CaptainBertie/D-Sentry/Mechanical/Gcode/README.md

# Gcode

Sliced for a Prusa MK3S: PETG, 0.6 mm nozzle, 0.35 mm layers unless noted; the pan pinion in
nylon.

- **`final/`**: the turret's parts: `Base`, `Foot`, `Frame`, `Gears`, `LeftLid`, `LeftMount`,
  `RightMount`, `RLid+BC`, `Shooter`, `ShooterBase`, `ShooterPinion`, `TiltGear`, `TiltPinion`,
  `CFPinion`, `LCD+NEMA`, `Rack`.
- **`testing/`**: fit and calibration prints (bearing, bolt, nut, pin, magnet, switch and
  mount-width tests), an early frame, and five earlier racks.

Measured results: `../fitment.md`.
