CaptainBertie/D-Sentry/Mechanical/fitment.md

# Fitment

Measured from the fit-test prints in `Gcode/testing/`.

## Fastener holes

The same sizes work for vertical and horizontal holes.

| Fastener | Clearance | Self-tap | Counterbore |
|---|---|---|---|
| M2 | 2.7 mm | 2.3 mm | 3.9 mm |
| M3 | 3.6 mm | 3.1 mm | 6.2 mm |
| M4 | 4.5 mm | 4.1 mm | 8.1 mm |

Where each size goes:

- **M4**: frame (self-tap, clearance, push-in nut), left and right mounts (clearance, push-in
  nut), left and right lids, bottom panel and base (clearance).
- **M3**: frame and left mount (self-tap).
- **M2**: frame (self-tap).
- **M5**: shooter (clearance).

## Other fits

| Fit | Value | Notes |
|---|---|---|
| 608 bearing | 22.3 mm OD, 7.1 mm ID | Nominal is 22 × 7 mm. |
| BB cartridge | −0.3 mm, bottom removed, 0.6 mm stickout | |
| Foot well | 21 mm | |
| Window | 3.175 mm wide | Laser-cut acrylic. |
| LCD pocket | −0.1 mm | Press fit. |
| NEMA D-shaft bore | 5.20 mm Ø, 4.7 mm across the flat | |
