CaptainBertie/D-Sentry/Software/firmware-architecture.html

D-SENTRY · FIRMWARE ARCHITECTURE

# How the turret decides, and what it's wired to

Two diagrams built from docs/architecture.md and firmware-ra4m1/dsentry/src/App.cpp: first, every path a button press can take to reach the RA4M1's motors and servo — and which one wins when more than one is live. Second, the exact order App::loop() runs, forever, and the state machine its one decision-maker steps through.

control data — commands the turret acts on telemetry / status — reported back mechanical / sensor wiring bench override — always wins

## 01 System block diagram

The Xbox pad reaches the RA4M1 brain by one of three paths, never more than one at a time. A valid packet over the USB bench cable always beats the radio, and switching which path is active counts as a link loss — the turret stops and comes back disarmed.

Dashed arrows at top: the pad pairs with exactly one side, chosen by the A1 mode toggle. The USB path (thick, from the Mac) is the bench override — it wins over either radio path whenever a valid packet has arrived in the last LINK_TIMEOUT_MS, and swapping which source is live is itself treated as a link loss.

## 02 Firmware flowchart

dsentry.ino is two lines: app.begin() once, then app.loop() forever. Both run in a fixed order the modules depend on — this is that order, from App.cpp.

Nothing in loop() blocks except SERVO ADJUST's save (about 50 ms, only in DISARMED with nothing moving) — that's the one documented exception to the no-delay() rule.

What TurretState.update() moves through, from docs/architecture.md §6. Solid arrows are the normal path; dashed arrows are the fault branch, which can cut in from calibrating, disarmed or armed.

Source: docs/architecture.md · firmware-ra4m1/dsentry/src/App.cpp · firmware-ra4m1/dsentry/src/TurretState.h — d-sentry branch, as of 2026-11-03.
