CaptainBertie/D-Sentry/Software/architecture-diagram.png

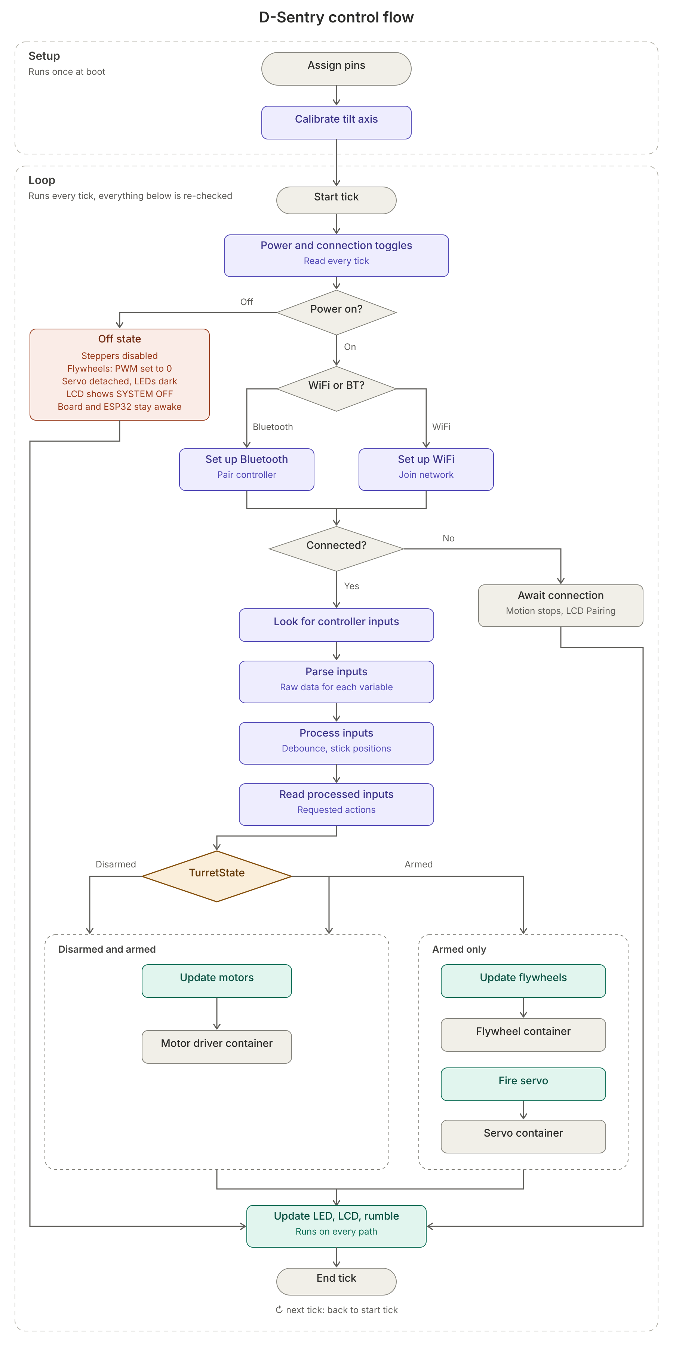
Software/architecture-diagram.png
