CaptainBertie/D-Sentry/Mechanical/CAD/vendor-parts/battery-6s-5200mah/Battery Screenshot.png

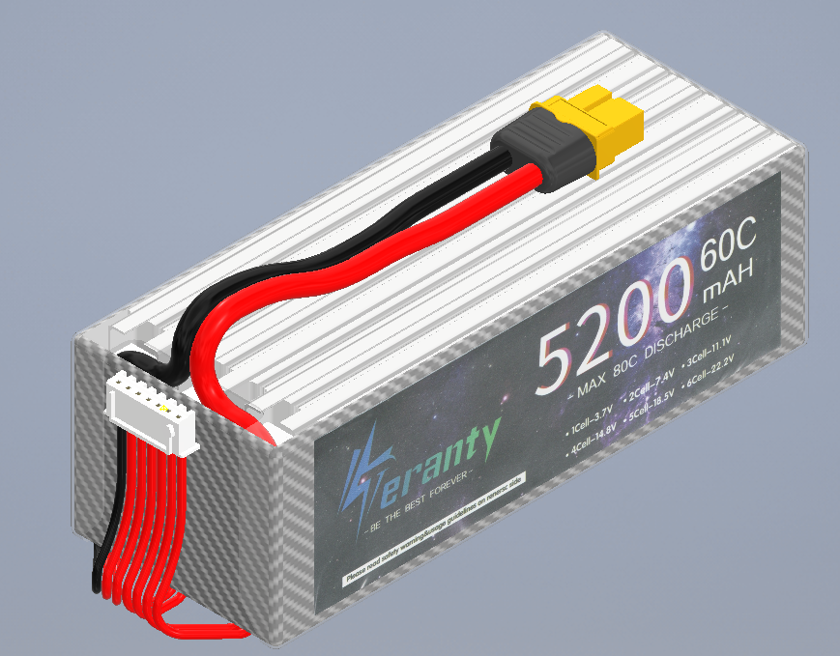
Mechanical/CAD/vendor-parts/battery-6s-5200mah/Battery Screenshot.png
