CaptainBertie/D-Sentry/Mechanical/CAD/vendor-parts/battery-6s-5200mah/Label - Front.jpg

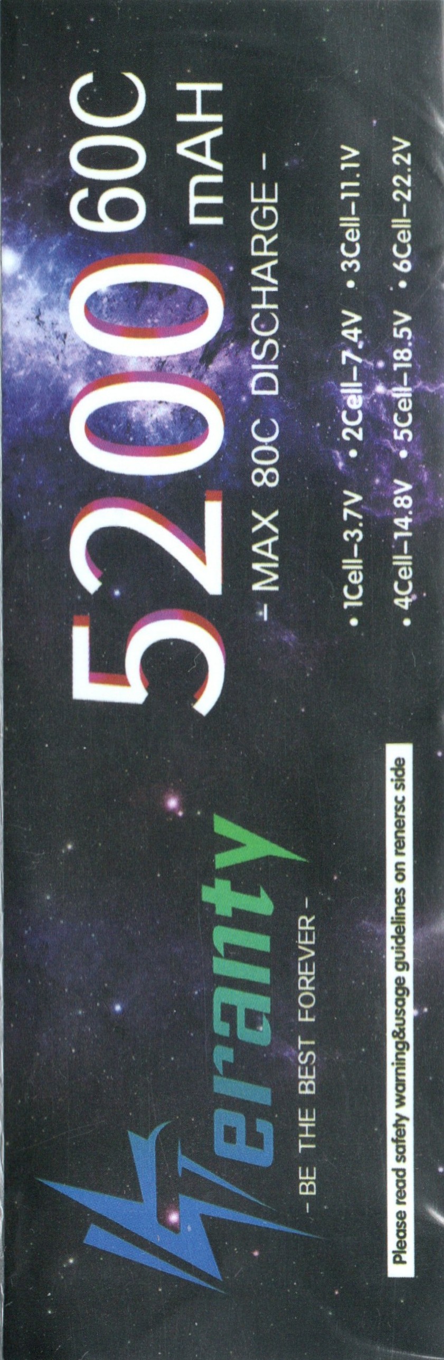
Mechanical/CAD/vendor-parts/battery-6s-5200mah/Label - Front.jpg
