CaptainBertie/D-Sentry/Mechanical/CAD/vendor-parts/cnc-shield-v3/Arduino_CNC_Assembly.STEP

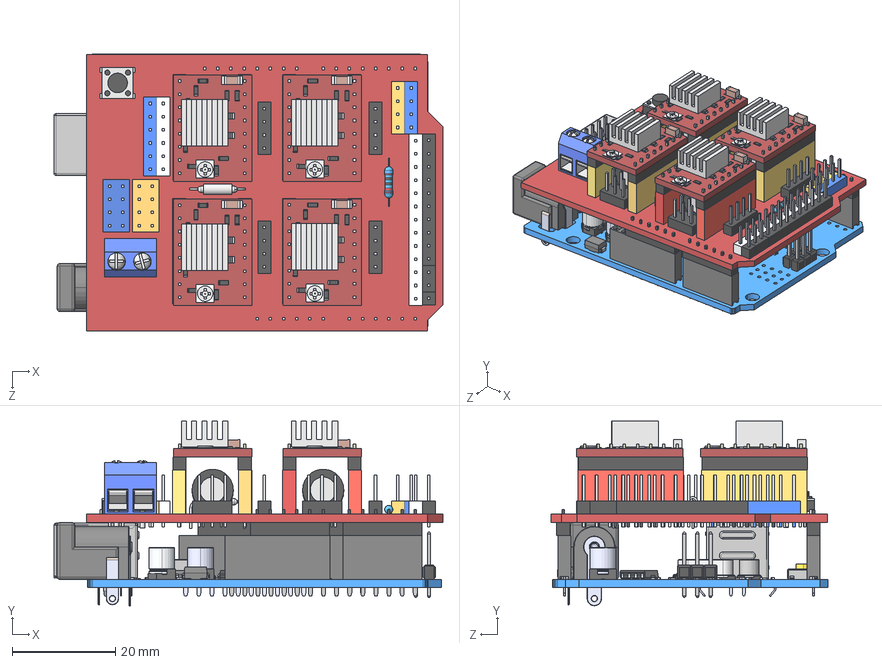
[picture p7: CAD file, 2026-11-13]
Mechanical/CAD/vendor-parts/cnc-shield-v3/Arduino_CNC_Assembly.STEP
75.3 x 35.7 x 53.6 mm
PCB.stp
USB-B.stp
DC_Jack.stp
Header female 8.stp
Header female 10.stp
Header female 8 (2).stp
Header female 6.stp
Header male 2.stp
Header male 2 (2).stp
Header male 2 (3).stp
Atmega328p-AU.stp
Diode.stp
LM358.stp
16MHZ Crystal.stp
16MHZ Crystal (2).stp
0603 Package.stp
0603 Package (2).stp
0603 Package (3).stp
0603 Package (4).stp
0603 Package (5).stp
0603 Package (6).stp
0603 Package (7).stp
0603 Package (8).stp
R1.stp
0603 Package (24).stp
0603 Package (23).stp
0603 Package (22).stp
0603 Package (21).stp
0603 Package (20).stp
0603 Package (19).stp
0603 Package (18).stp
0603 Package (17).stp
0603 Package (16).stp
0603 Package (15).stp
0603 Package (14).stp
0603 Package (13).stp
0603 Package (12).stp
0603 Package (11).stp
0603 Package (10).stp
0603 Package (9).stp
CH340G.stp
47uF 27v cap.stp
47uF 27v cap (2).stp
LM1117.stp
Transistor SOC Package.stp
Transistor SOC Package (2).stp
A sexy yellow button.stp
Arduino_Uno_CNC_Shield_V3
