CaptainBertie/D-Sentry/Mechanical/CAD/vendor-parts/l298n-stepper-driver/ENB Pin.SLDASM

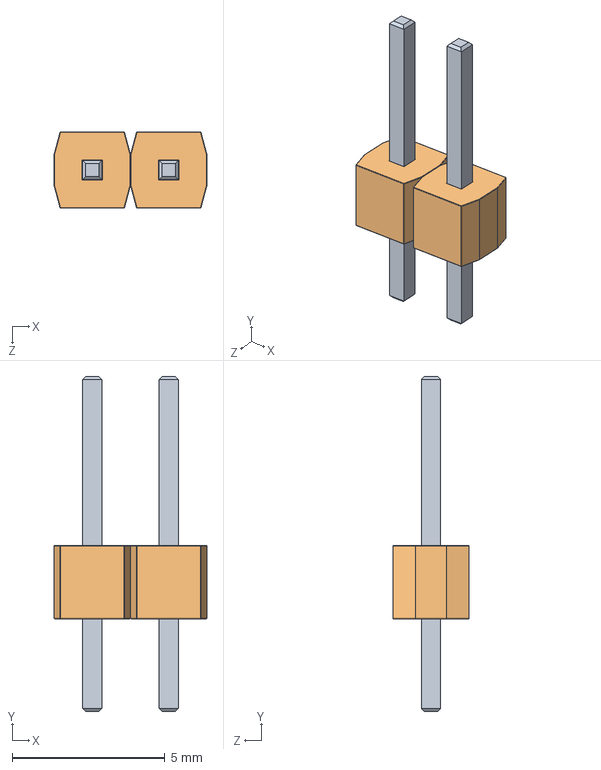
[picture p8: CAD file, 2026-11-13]
Mechanical/CAD/vendor-parts/l298n-stepper-driver/ENB Pin.SLDASM
5.00 x 10.9 x 2.50 mm
Spacer x 2
Male Header Pin x 2
