CaptainBertie/D-Sentry/Mechanical/CAD/vendor-parts/servo-fs90r/Solidworks 2022/Fitec FS90R_Micro Servo.SLDASM

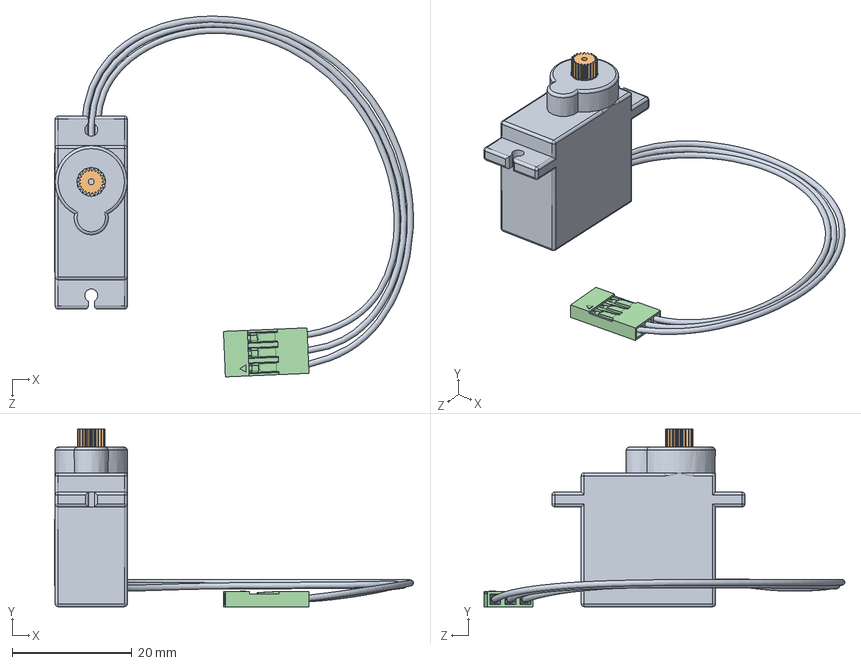
[picture p9: CAD file, 2026-11-13]
Mechanical/CAD/vendor-parts/servo-fs90r/Solidworks 2022/Fitec FS90R_Micro Servo.SLDASM
60.0 x 29.7 x 60.3 mm
FS90R_Housing
spur gear_din_0.2M 21T 21PA 3FW
Label
BLS-3 by Dmitry Levin.step
