CaptainBertie/D-Sentry/Mechanical/CAD/vendor-parts/l298n-stepper-driver/Left Cap.SLDASM

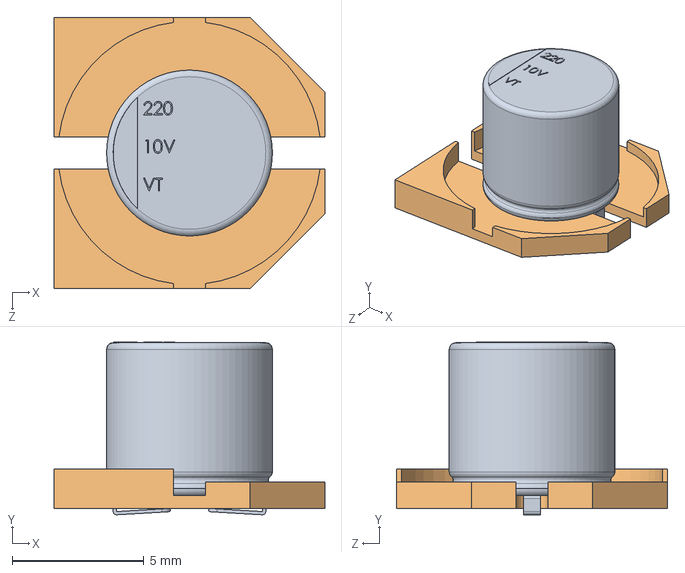
[picture p10: CAD file, 2026-11-13]
Mechanical/CAD/vendor-parts/l298n-stepper-driver/Left Cap.SLDASM
10.3 x 6.56 x 10.3 mm
Plastic Base
Cap Body
