CaptainBertie/D-Sentry/Mechanical/CAD/meshes/ShooterProto.3mf

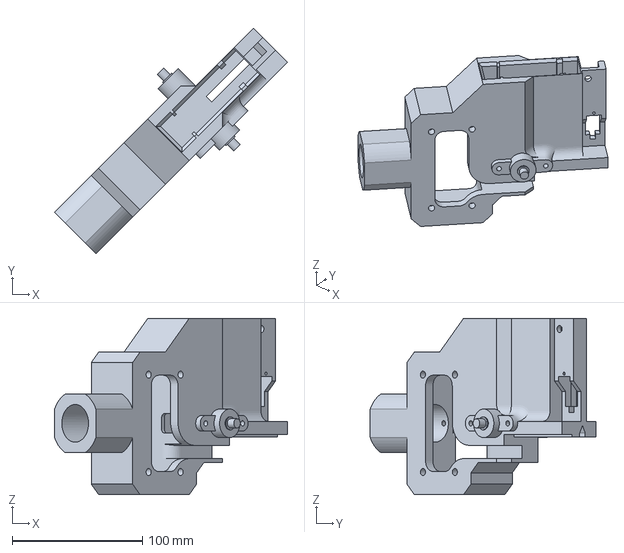
[picture p11: CAD file, 2026-11-13]
Mechanical/CAD/meshes/ShooterProto.3mf
179.1 x 173.4 x 135.5 mm
