CaptainBertie/D-Sentry/Mechanical/CAD/vendor-parts/battery-6s-5200mah/6S  22.2v 5200maH 60C .stp

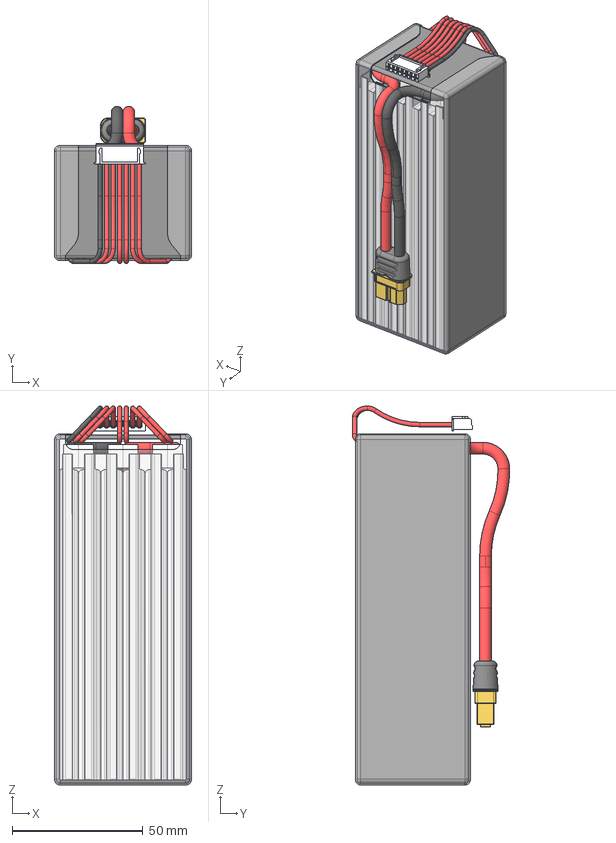
[picture p12: CAD file, 2026-11-13]
Mechanical/CAD/vendor-parts/battery-6s-5200mah/6S 22.2v 5200maH 60C .stp
52.5 x 60.2 x 145.2 mm
3.7v Cell x 6
Wrapper
Shrink Wrap
XT60H - Female
Power Cable
XHP
Charging Cables
