CaptainBertie/D-Sentry/Mechanical/CAD/vendor-parts/servo-fs90r/Solidworks 2022/spur gear_din_0.2M 21T 21PA 3FW.sldprt

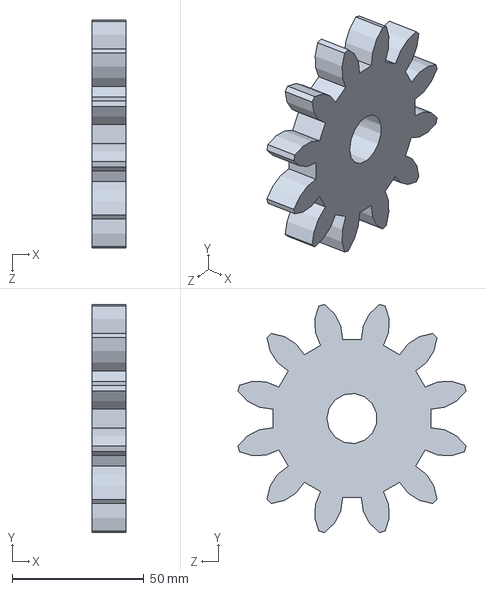
[picture p14: CAD file, 2026-11-13]
Mechanical/CAD/vendor-parts/servo-fs90r/Solidworks 2022/spur gear_din_0.2M 21T 21PA 3FW.sldprt
12.7 x 86.4 x 86.4 mm
