CaptainBertie/D-Sentry/Mechanical/CAD/vendor-parts/servo-fs90r/STEP/BLS-3 by Dmitry Levin.step

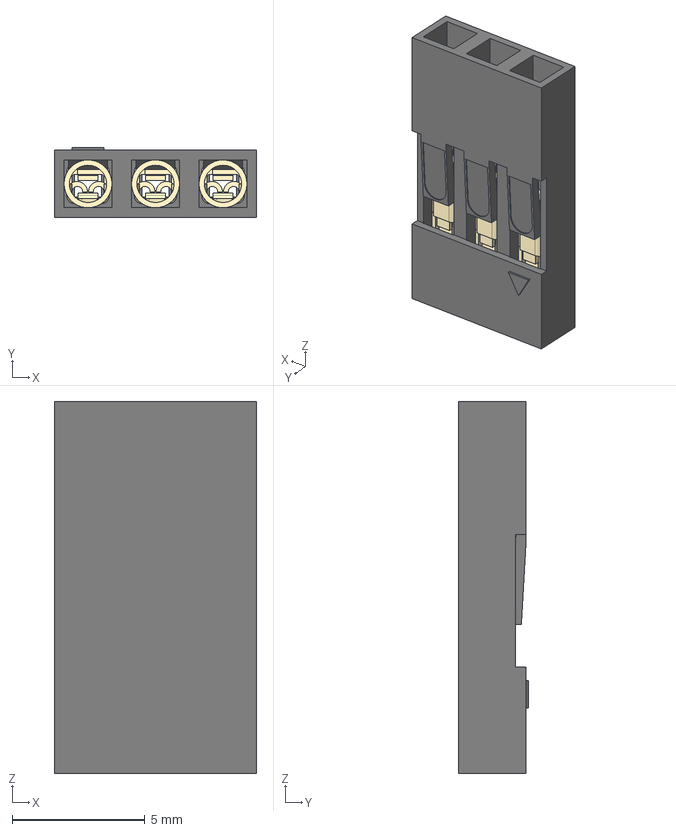
[picture p15: CAD file, 2026-11-13]
Mechanical/CAD/vendor-parts/servo-fs90r/STEP/BLS-3 by Dmitry Levin.step
7.62 x 2.64 x 14.0 mm
