CaptainBertie/D-Sentry/Mechanical/CAD/meshes/Body (10 rounds).stl

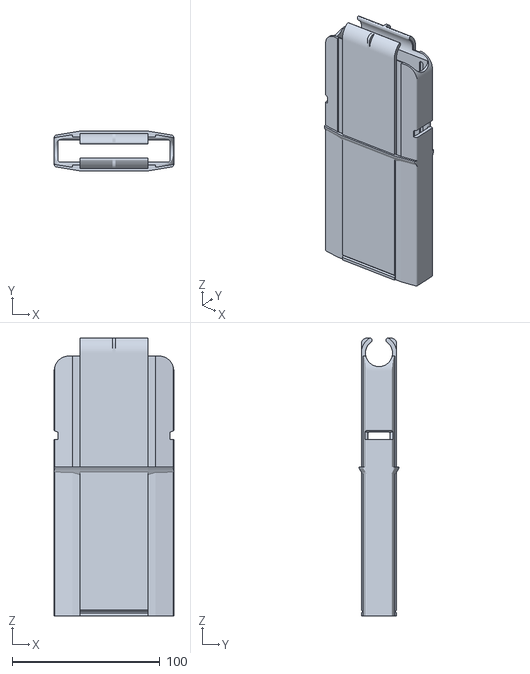
[picture p16: CAD file, 2026-11-13]
Mechanical/CAD/meshes/Body (10 rounds).stl
81.0 x 27.0 x 188.2
