CaptainBertie/D-Sentry/Mechanical/CAD/vendor-parts/servo-fs90r/Solidworks 2022/Label.SLDPRT

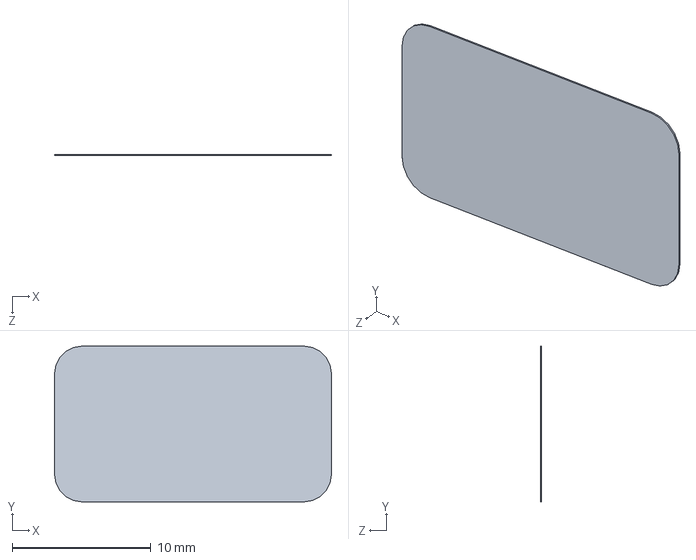
[picture p17: CAD file, 2026-11-13]
Mechanical/CAD/vendor-parts/servo-fs90r/Solidworks 2022/Label.SLDPRT
20.0 x 11.2 x 0.1 mm
