CaptainBertie/D-Sentry/Mechanical/CAD/vendor-parts/servo-fs90r/STEP/Fitec FS90R Micro Servo NoWires.STEP

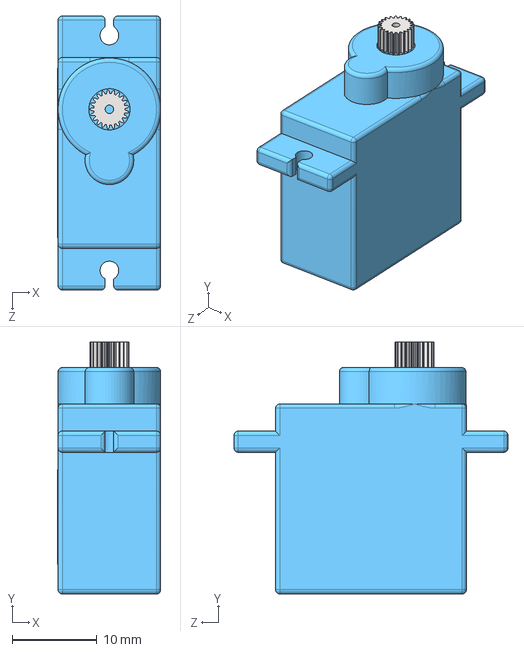
[picture p18: CAD file, 2026-11-13]
Mechanical/CAD/vendor-parts/servo-fs90r/STEP/Fitec FS90R Micro Servo NoWires.STEP
12.2 x 29.7 x 32.3 mm
