CaptainBertie/D-Sentry/Mechanical/CAD/vendor-parts/l298n-stepper-driver/Plastic Base.SLDPRT

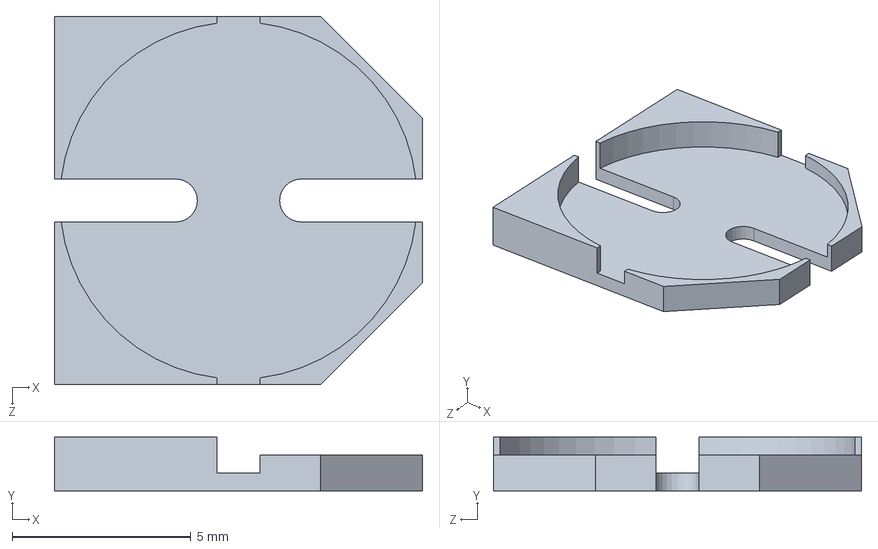
[picture p19: CAD file, 2026-11-13]
Mechanical/CAD/vendor-parts/l298n-stepper-driver/Plastic Base.SLDPRT
10.3 x 1.50 x 10.3 mm
