CaptainBertie/D-Sentry/Mechanical/CAD/meshes/Window Profile.dxf

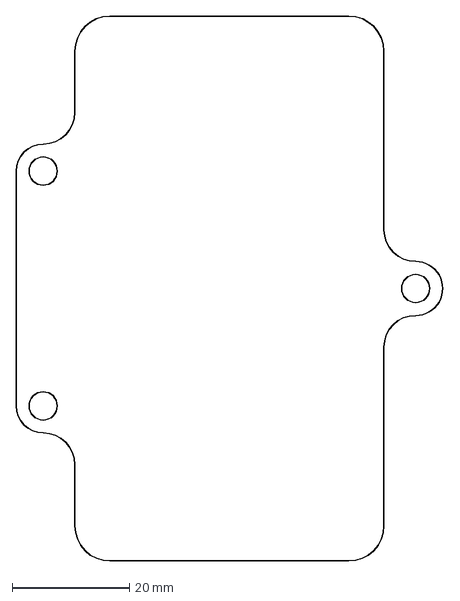
[picture p20: CAD file, 2026-11-13]
Mechanical/CAD/meshes/Window Profile.dxf
72.9 x 92.8 mm
