CaptainBertie/D-Sentry/Mechanical/CAD/vendor-parts/servo-fs90r/Solidworks 2022/FS90R_Housing.SLDPRT

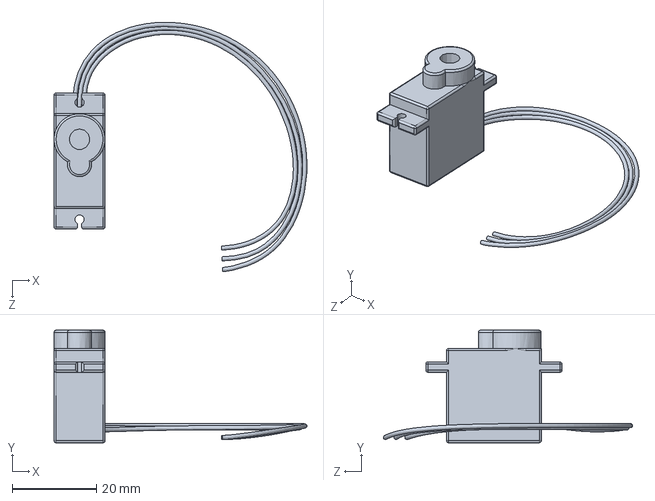
[picture p21: CAD file, 2026-11-13]
Mechanical/CAD/vendor-parts/servo-fs90r/Solidworks 2022/FS90R_Housing.SLDPRT
59.9 x 26.7 x 59.1 mm
