CaptainBertie/D-Sentry/Mechanical/CAD/meshes/MAG 10 round.3mf

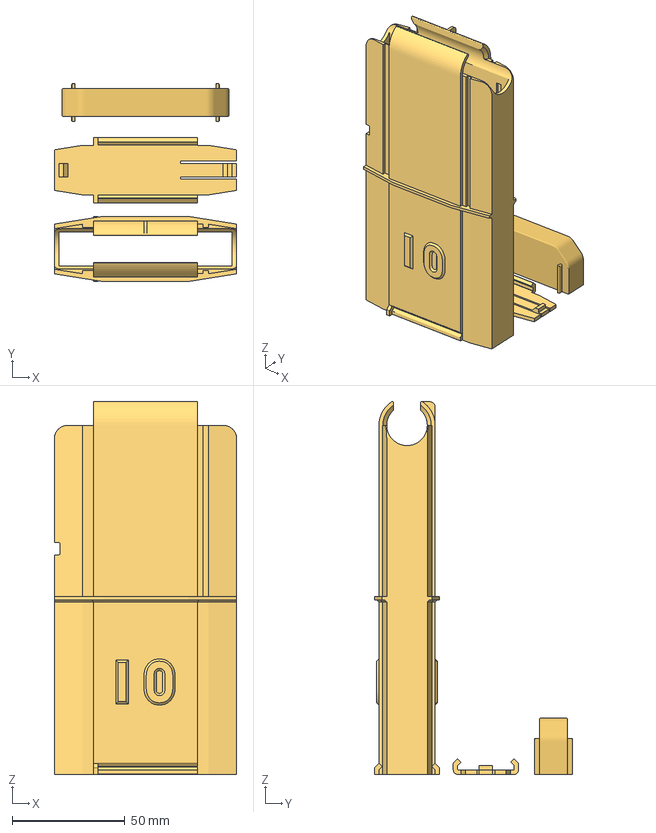
[picture p22: CAD file, 2026-11-13]
Mechanical/CAD/meshes/MAG 10 round.3mf
81.0 x 88.0 x 165.6 mm
MAG body
MAG bottom slot
MAG spring top
