CaptainBertie/D-Sentry/Mechanical/CAD/vendor-parts/l298n-stepper-driver/Cap Body.SLDPRT

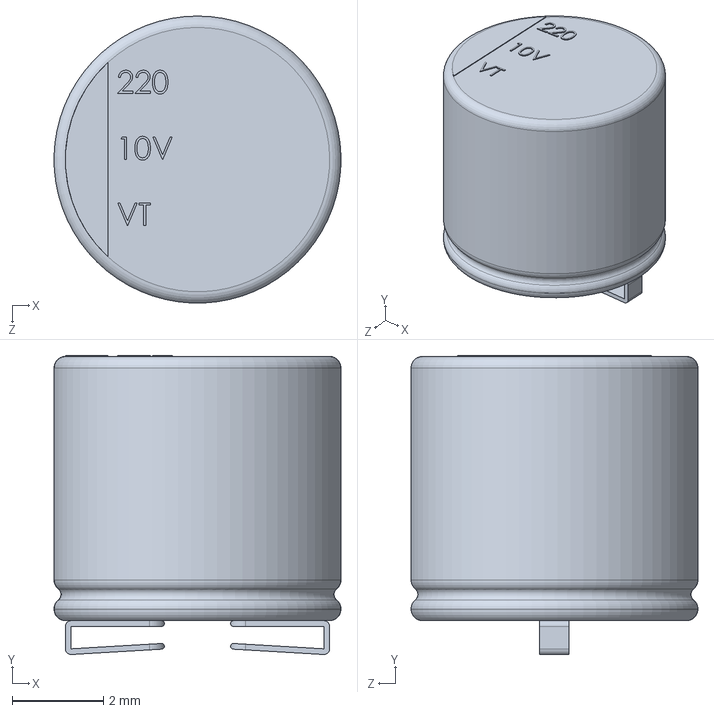
[picture p23: CAD file, 2026-11-13]
Mechanical/CAD/vendor-parts/l298n-stepper-driver/Cap Body.SLDPRT
6.30 x 6.56 x 6.30 mm
