CaptainBertie/D-Sentry/Mechanical/CAD/meshes/Enclosure_top-ptfe.stl

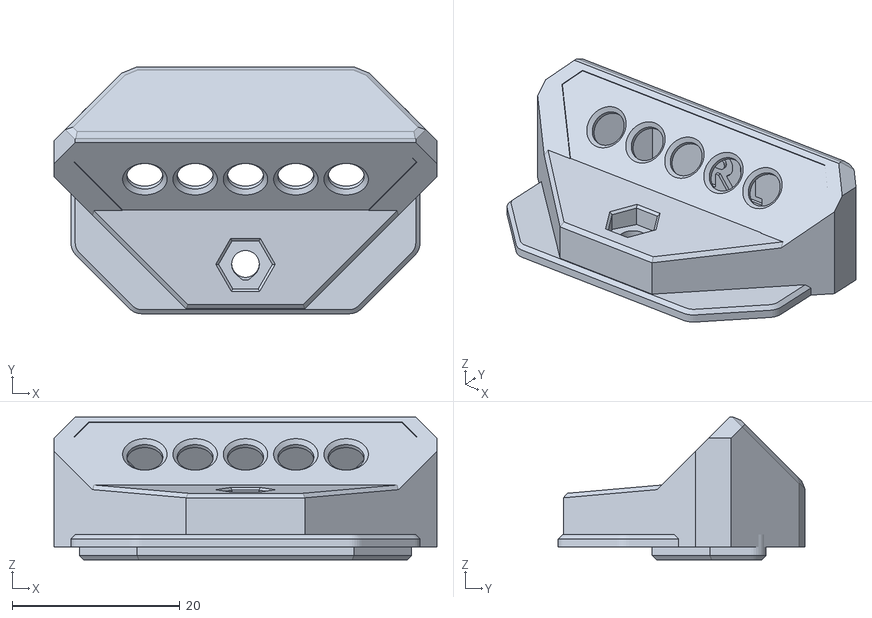
[picture p24: CAD file, 2026-11-13]
Mechanical/CAD/meshes/Enclosure_top-ptfe.stl
45.7 x 29.4 x 17.0
