CaptainBertie/D-Sentry/Mechanical/CAD/meshes/MagnetTest.3mf

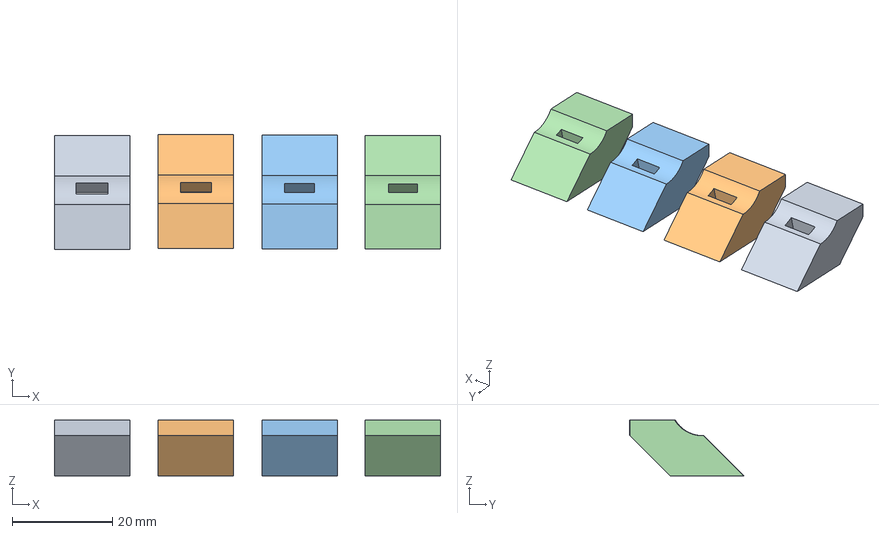
[picture p25: CAD file, 2026-11-13]
Mechanical/CAD/meshes/MagnetTest.3mf
76.9 x 22.8 x 11.1 mm
