CaptainBertie/D-Sentry/Mechanical/CAD/meshes/Frame.3mf

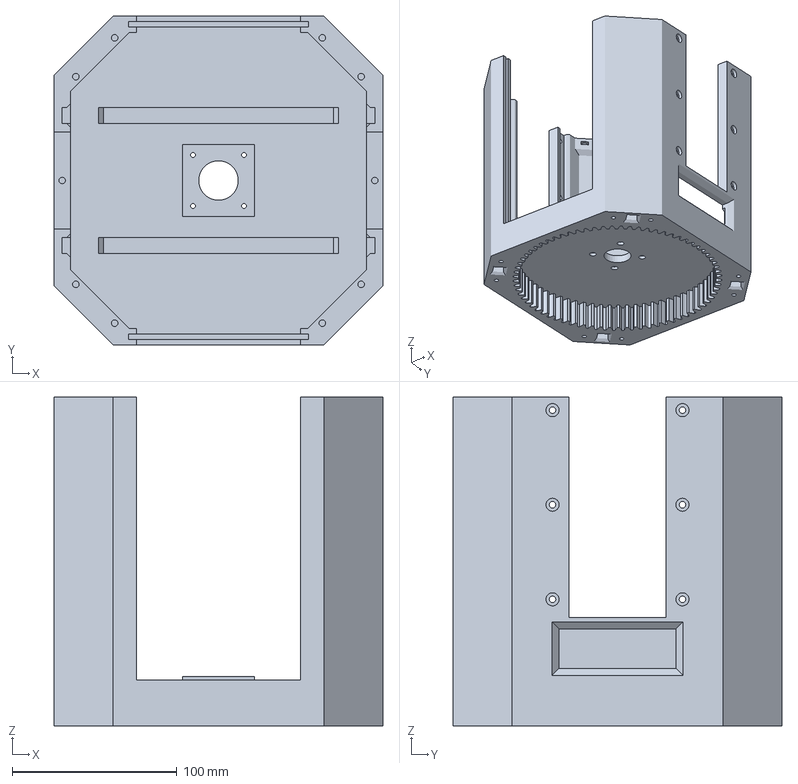
[picture p26: CAD file, 2026-11-13]
Mechanical/CAD/meshes/Frame.3mf
200.0 x 200.0 x 200.0 mm
