CaptainBertie/D-Sentry/Mechanical/CAD/meshes/SwitchTest.3mf

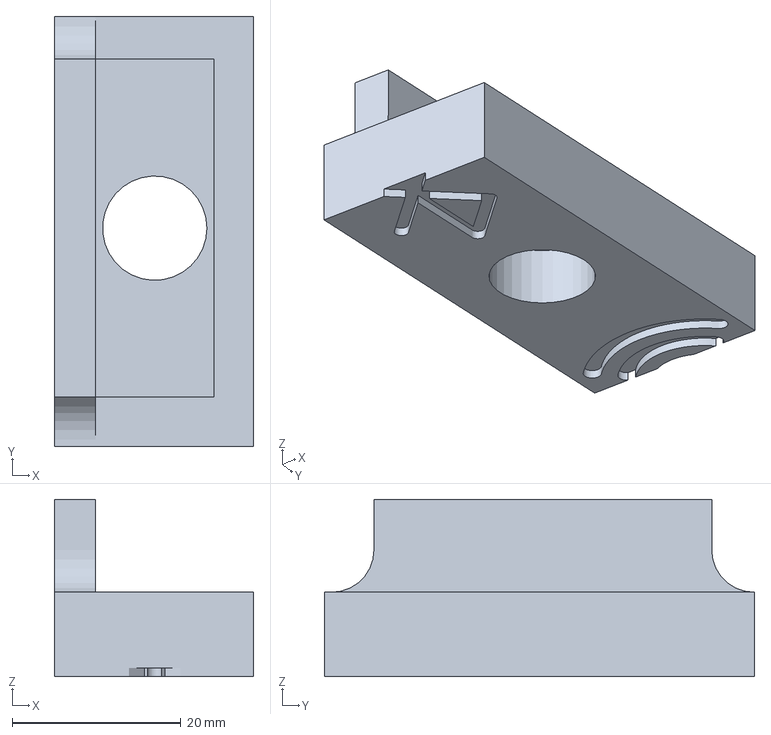
[picture p27: CAD file, 2026-11-13]
Mechanical/CAD/meshes/SwitchTest.3mf
23.6 x 50.9 x 21.0 mm
