CaptainBertie/D-Sentry/Mechanical/CAD/meshes/MagTest.3mf

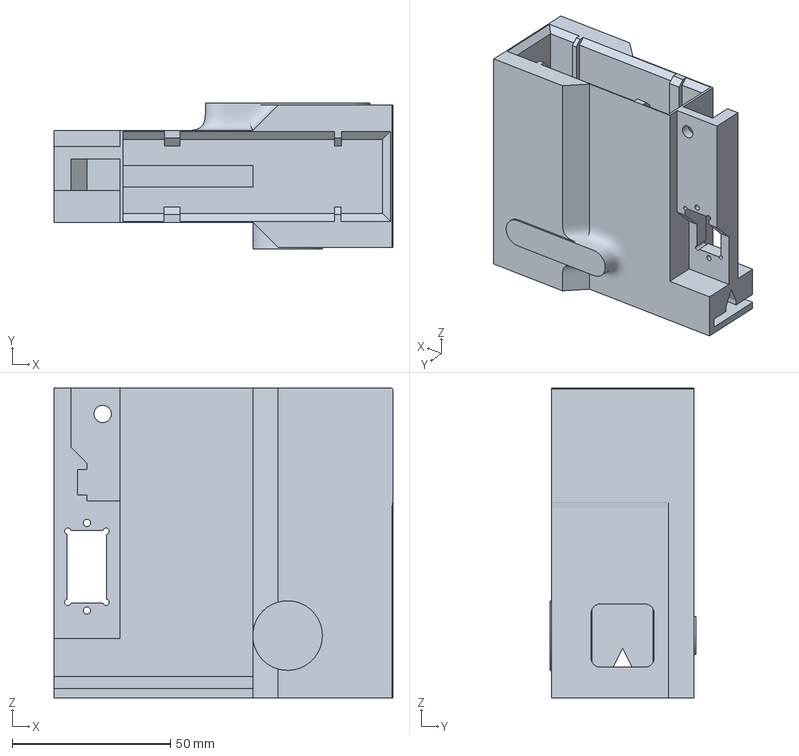
[picture p28: CAD file, 2026-11-13]
Mechanical/CAD/meshes/MagTest.3mf
107.1 x 46.2 x 97.9 mm
