CaptainBertie/D-Sentry/Mechanical/CAD/vendor-parts/l298n-stepper-driver/L298N.SLDPRT

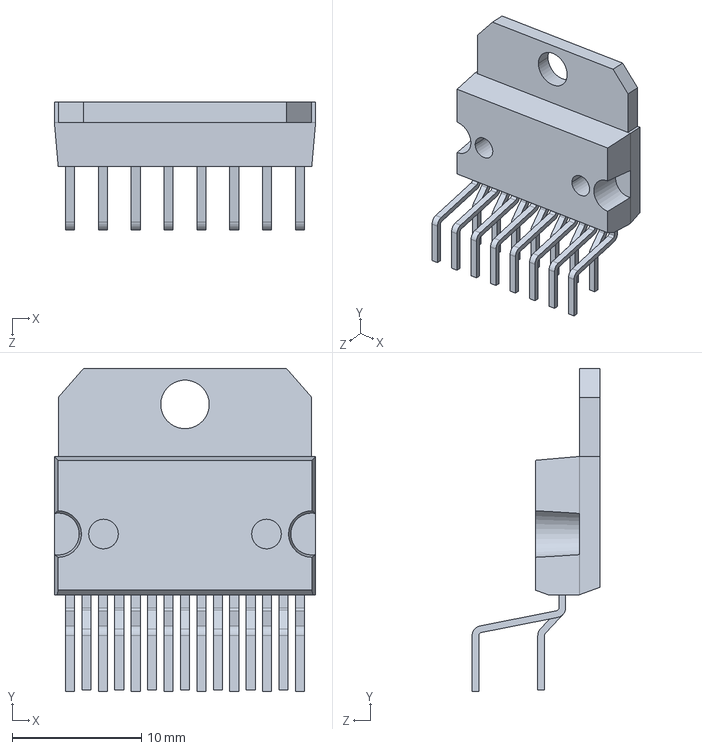
[picture p29: CAD file, 2026-11-13]
Mechanical/CAD/vendor-parts/l298n-stepper-driver/L298N.SLDPRT
20.2 x 25.0 x 9.89 mm
