CaptainBertie/D-Sentry/Mechanical/CAD/meshes/Clip_Mania_39mm.stl

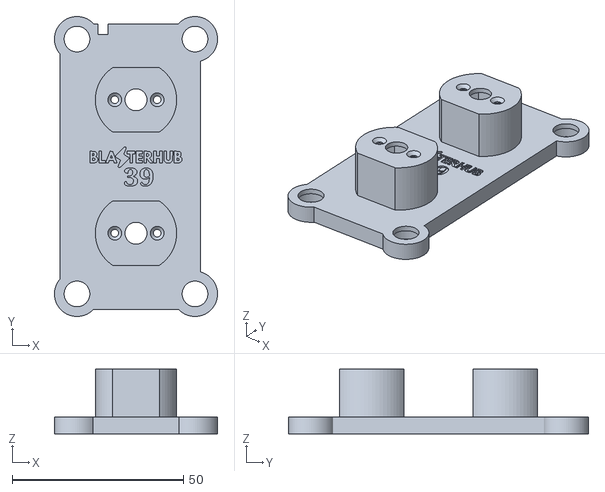
[picture p30: CAD file, 2026-11-13]
Mechanical/CAD/meshes/Clip_Mania_39mm.stl
47.7 x 87.7 x 19.0
