CaptainBertie/D-Sentry/Mechanical/CAD/vendor-parts/l298n-stepper-driver/Spacer.SLDPRT

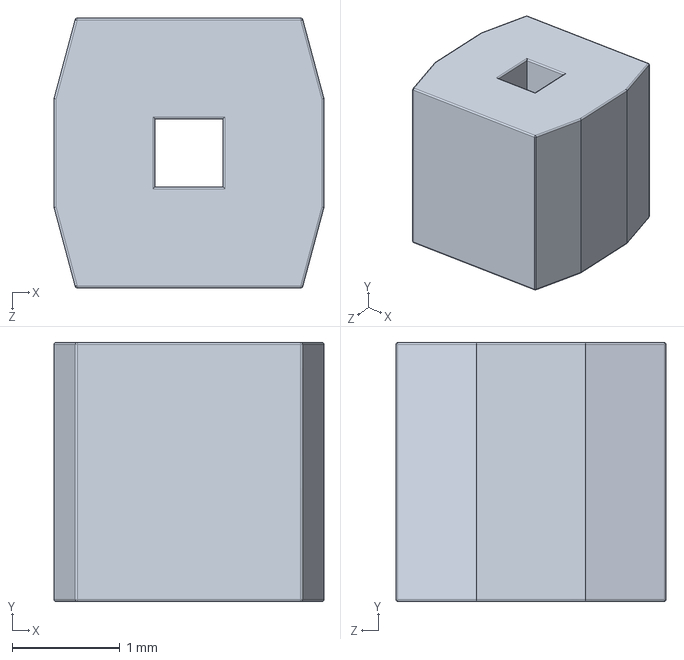
[picture p31: CAD file, 2026-11-13]
Mechanical/CAD/vendor-parts/l298n-stepper-driver/Spacer.SLDPRT
2.50 x 2.40 x 2.50 mm
