CaptainBertie/D-Sentry/Mechanical/CAD/vendor-parts/l298n-stepper-driver/Cap 1.SLDPRT

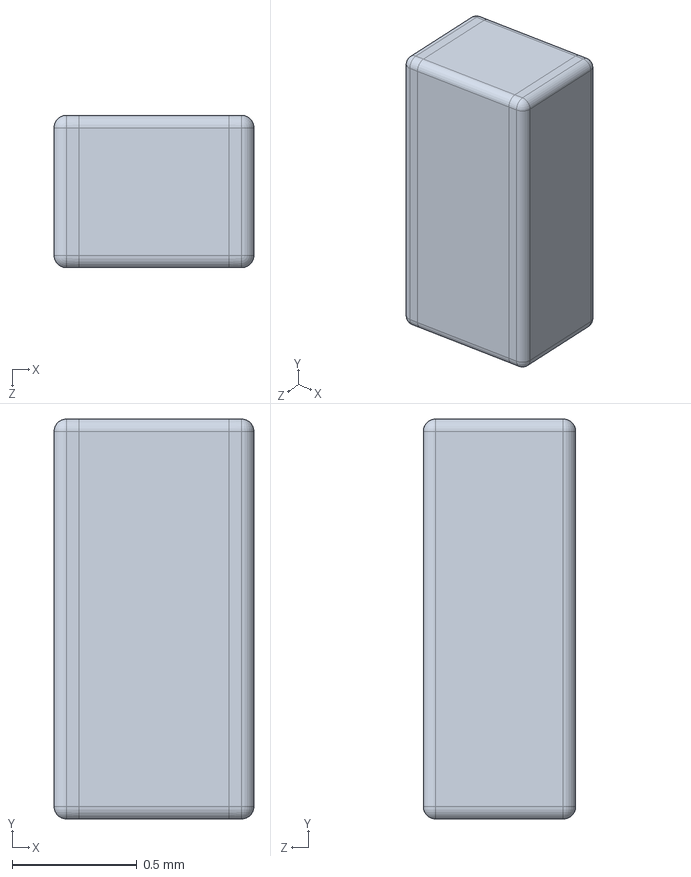
[picture p32: CAD file, 2026-11-13]
Mechanical/CAD/vendor-parts/l298n-stepper-driver/Cap 1.SLDPRT
0.8 x 1.60 x 0.61 mm
