CaptainBertie/D-Sentry/Mechanical/CAD/vendor-parts/l298n-stepper-driver/Left Out Connector.SLDPRT

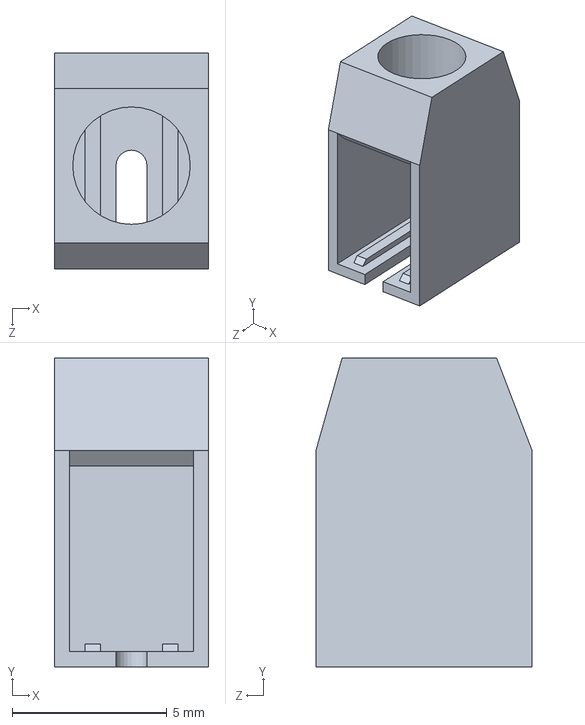
[picture p33: CAD file, 2026-11-13]
Mechanical/CAD/vendor-parts/l298n-stepper-driver/Left Out Connector.SLDPRT
5.00 x 10.0 x 7.00 mm
