CaptainBertie/D-Sentry/Mechanical/CAD/vendor-parts/l298n-stepper-driver/Jumper Body.SLDPRT

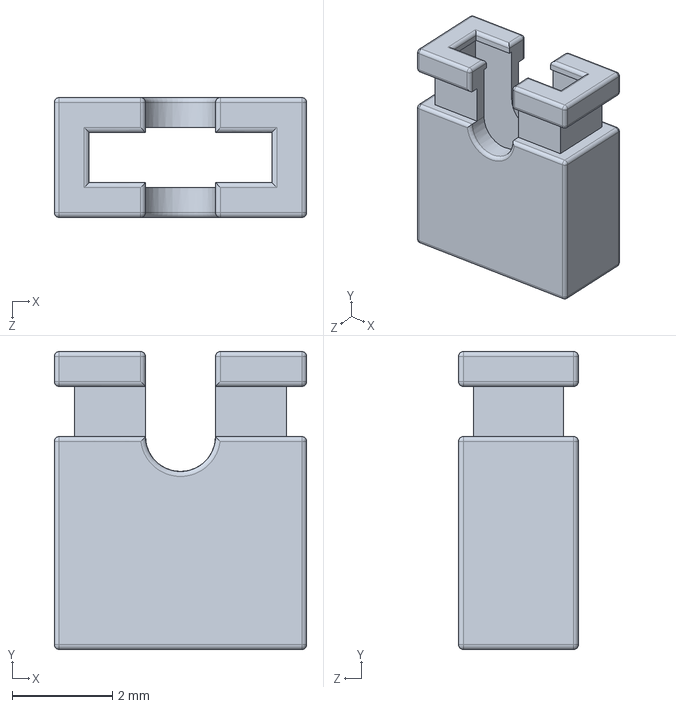
[picture p34: CAD file, 2026-11-13]
Mechanical/CAD/vendor-parts/l298n-stepper-driver/Jumper Body.SLDPRT
5.05 x 5.96 x 2.40 mm
