CaptainBertie/D-Sentry/Mechanical/CAD/vendor-parts/l298n-stepper-driver/M7 Chip Diode.SLDPRT

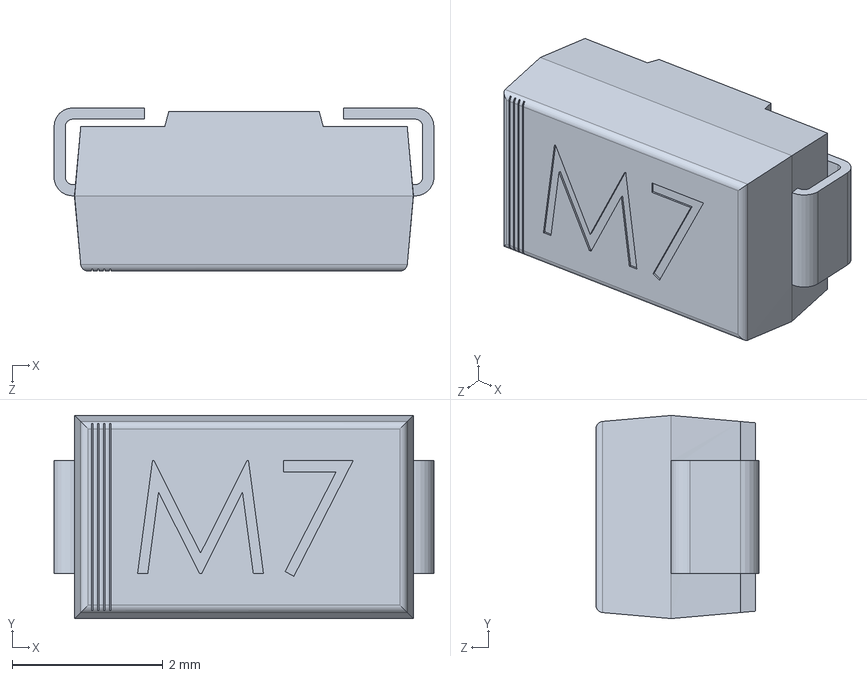
[picture p35: CAD file, 2026-11-13]
Mechanical/CAD/vendor-parts/l298n-stepper-driver/M7 Chip Diode.SLDPRT
5.05 x 2.70 x 2.17 mm
