CaptainBertie/D-Sentry/Mechanical/CAD/vendor-parts/l298n-stepper-driver/Male Header Pin.SLDPRT

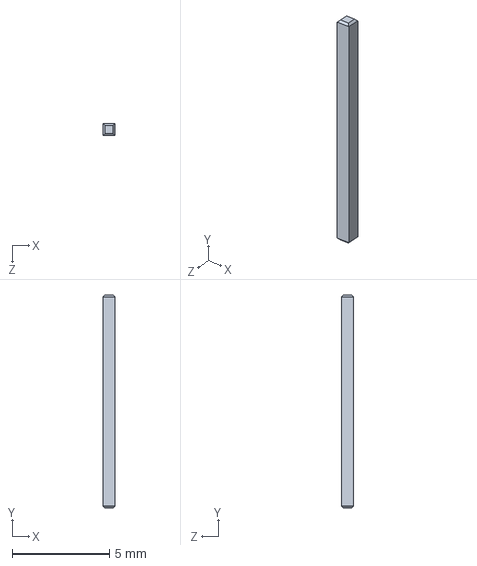
[picture p36: CAD file, 2026-11-13]
Mechanical/CAD/vendor-parts/l298n-stepper-driver/Male Header Pin.SLDPRT
0.63 x 10.9 x 0.63 mm
