CaptainBertie/D-Sentry/Mechanical/CAD/vendor-parts/l298n-stepper-driver/LED.SLDPRT

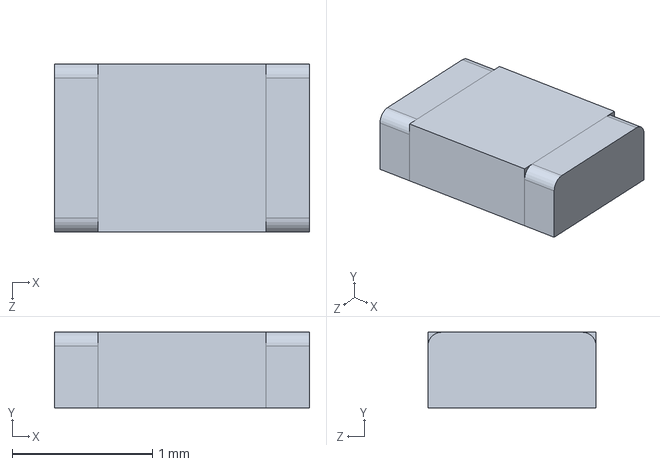
[picture p37: CAD file, 2026-11-13]
Mechanical/CAD/vendor-parts/l298n-stepper-driver/LED.SLDPRT
1.82 x 0.54 x 1.20 mm
