CaptainBertie/D-Sentry/Mechanical/CAD/vendor-parts/l298n-stepper-driver/L298N Driver.STEP

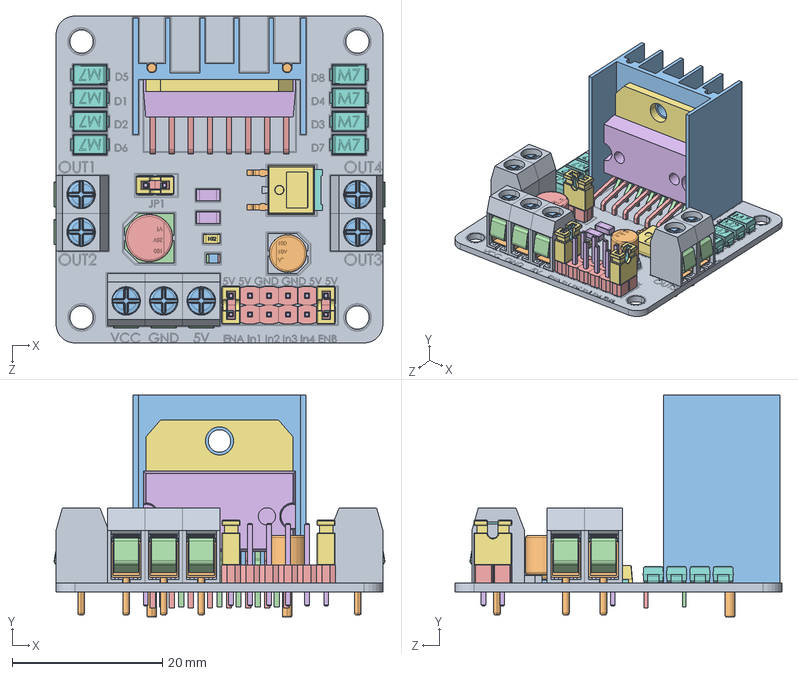
[picture p38: CAD file, 2026-11-13]
Mechanical/CAD/vendor-parts/l298n-stepper-driver/L298N Driver.STEP
44.0 x 29.5 x 43.5 mm
Board
L298N Heat Sink
L298N
M7 Chip Diode x 7
D5
Left Out Connector x 7
Wire Socket x 7
Set Screw x 7
Wire Tension Clip x 7
Spacer x 14
Male Header Pin x 14
Jumper Body x 3
Metal Insert x 3
Plastic Base_10V 100uf
Cap Body_10V 100uf
Plastic Base_35V 100uf
Cap Body_35V 100uf
TO-252_body.stp
TO-252_heatsink_2.stp
TO-252_pin_short.stp
TO-252_pin_standart.stp x 2
LED
Cap 2_CAPC3216X105N
Cap 1_CAPC3216X105N
Resistor
