CaptainBertie/D-Sentry/Mechanical/CAD/vendor-parts/l298n-stepper-driver/Board.SLDPRT

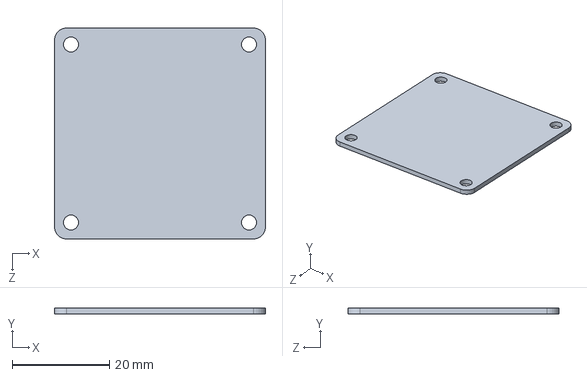
[picture p39: CAD file, 2026-11-13]
Mechanical/CAD/vendor-parts/l298n-stepper-driver/Board.SLDPRT
43.5 x 1.20 x 43.5 mm
