CaptainBertie/D-Sentry/Mechanical/CAD/vendor-parts/l298n-stepper-driver/Resistor.SLDPRT

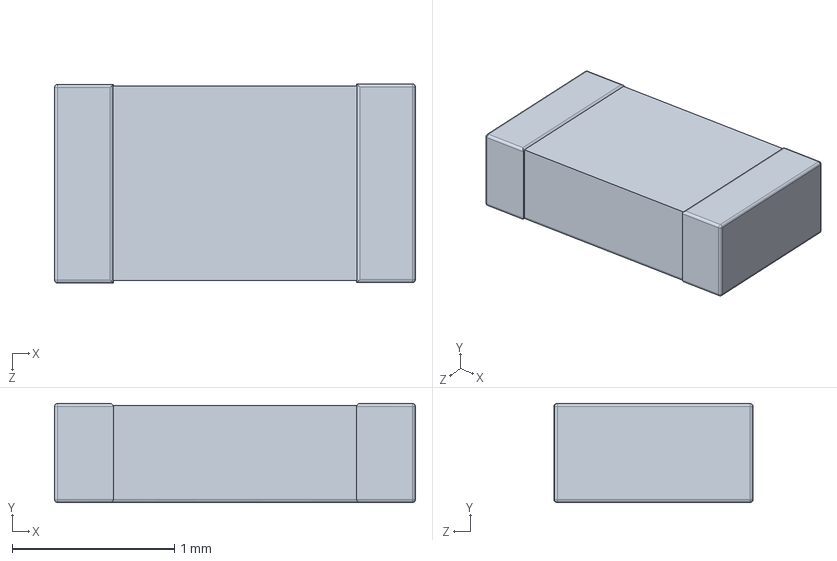
[picture p40: CAD file, 2026-11-13]
Mechanical/CAD/vendor-parts/l298n-stepper-driver/Resistor.SLDPRT
2.23 x 0.611 x 1.23 mm
