CaptainBertie/D-Sentry/Mechanical/CAD/vendor-parts/l298n-stepper-driver/L298N Heat Sink.SLDPRT

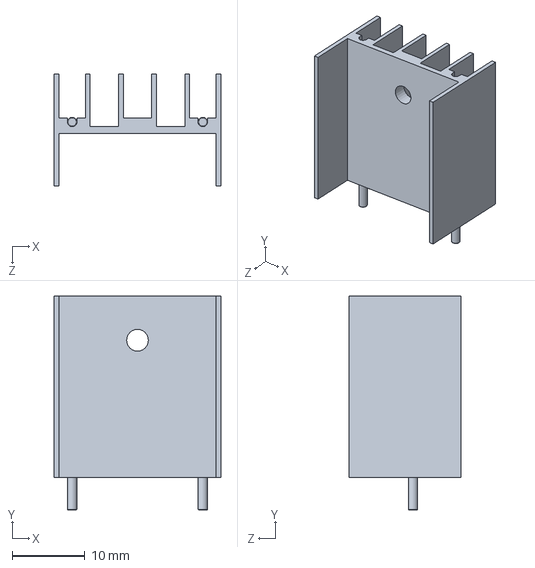
[picture p41: CAD file, 2026-11-13]
Mechanical/CAD/vendor-parts/l298n-stepper-driver/L298N Heat Sink.SLDPRT
23.0 x 29.5 x 15.5 mm
