CaptainBertie/D-Sentry/Mechanical/CAD/vendor-parts/l298n-stepper-driver/ENB Jumper.SLDASM

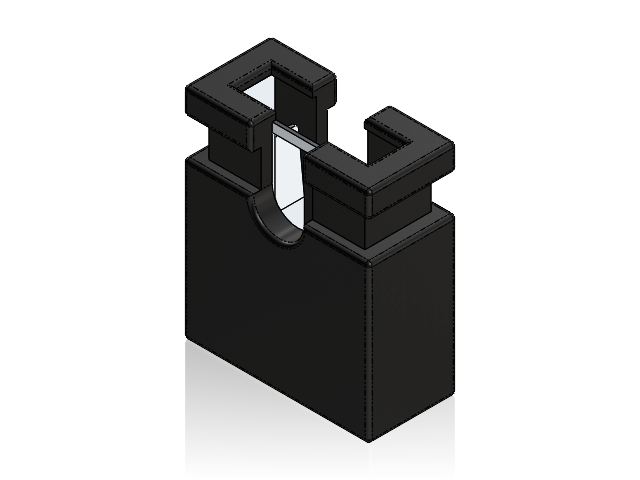
[picture p42: CAD file, 2026-11-13]
Mechanical/CAD/vendor-parts/l298n-stepper-driver/ENB Jumper.SLDASM
Jumper Body
Metal Insert
