CaptainBertie/D-Sentry/Mechanical/CAD/vendor-parts/l298n-stepper-driver/TO-252.SLDASM

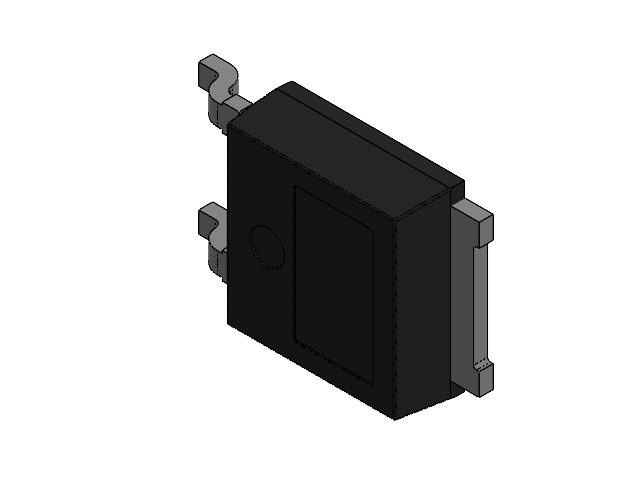
[picture p43: CAD file, 2026-11-13]
Mechanical/CAD/vendor-parts/l298n-stepper-driver/TO-252.SLDASM
TO-252_body.stp
TO-252_heatsink_2.stp
TO-252_pin_short.stp
TO-252_pin_standart.stp x 2
