CaptainBertie/D-Sentry/(list of files, cad)

Other CAD files:
Mechanical/CAD/vendor-parts/l298n-stepper-driver/Left Out Connector.SLDPRT.SLDASM
Mechanical/CAD/vendor-parts/l298n-stepper-driver/Voltage Connector.SLDASM
Mechanical/CAD/vendor-parts/l298n-stepper-driver/ENA Jumper.SLDASM
Mechanical/CAD/vendor-parts/l298n-stepper-driver/In4 Pin.SLDASM
Mechanical/CAD/vendor-parts/l298n-stepper-driver/In2 Pin.SLDASM
Mechanical/CAD/vendor-parts/l298n-stepper-driver/In1 Pin.SLDASM
Mechanical/CAD/vendor-parts/l298n-stepper-driver/Right Cap.SLDASM
Mechanical/CAD/vendor-parts/l298n-stepper-driver/ENA Pin.SLDASM
Mechanical/CAD/vendor-parts/l298n-stepper-driver/JP1.SLDASM
Mechanical/CAD/vendor-parts/l298n-stepper-driver/Right Out Connector.SLDASM
Mechanical/CAD/vendor-parts/l298n-stepper-driver/In3 Pin.SLDASM
Mechanical/CAD/vendor-parts/l298n-stepper-driver/JP1 Jumper.SLDASM
Mechanical/CAD/meshes/Untitled.3mf
Mechanical/CAD/vendor-parts/servo-fs90r/STEP/Fitec FS90R Micro Servo.step.SLDPRT
Mechanical/CAD/vendor-parts/servo-fs90r/STEP/Fitec FS90R Micro Servo NoWires.step.SLDPRT
Mechanical/CAD/vendor-parts/servo-fs90r/Solidworks 2022/BLS-3 by Dmitry Levin.step.SLDPRT
Mechanical/CAD/vendor-parts/servo-fs90r/STEP/Fitec FS90R Micro Servo.STEP
Mechanical/CAD/vendor-parts/servo-fs90r/STEP/Fitec FS90R Micro Servo NoConnector.step.SLDPRT
Mechanical/CAD/vendor-parts/l298n-stepper-driver/Metal Insert.SLDPRT
Mechanical/CAD/vendor-parts/servo-fs90r/Solidworks 2022/FS90R_Micro Servo.SLDPRT
Mechanical/CAD/vendor-parts/servo-fs90r/STEP/Fitec FS90R Micro Servo NoConnector.STEP
Mechanical/CAD/vendor-parts/l298n-stepper-driver/Wire Socket.SLDPRT
Mechanical/CAD/vendor-parts/l298n-stepper-driver/Wire Tension Clip.SLDPRT
Mechanical/CAD/vendor-parts/l298n-stepper-driver/D5.SLDPRT
Mechanical/CAD/vendor-parts/l298n-stepper-driver/Cap 2.SLDPRT
Mechanical/CAD/source/Fit Panel.f3d
Mechanical/CAD/source/Flywheel cage.f3d
Mechanical/CAD/source/Shooter.f3z
Mechanical/CAD/source/Turret.f3z
Mechanical/CAD/vendor-parts/battery-6s-5200mah/3.7v Cell.ipt
Mechanical/CAD/vendor-parts/battery-6s-5200mah/6S 22.2v 5200maH 60C .iam
Mechanical/CAD/vendor-parts/battery-6s-5200mah/Charging Cable Assembly.iam
Mechanical/CAD/vendor-parts/battery-6s-5200mah/Charging Cables.ipt
Mechanical/CAD/vendor-parts/battery-6s-5200mah/JST XHP-7 Female.ipt
Mechanical/CAD/vendor-parts/battery-6s-5200mah/OldVersions/3.7v Cell.0005.ipt
Mechanical/CAD/vendor-parts/battery-6s-5200mah/OldVersions/Power Cable Assembly.0004.iam
Mechanical/CAD/vendor-parts/battery-6s-5200mah/OldVersions/Power Cable.0004.ipt
Mechanical/CAD/vendor-parts/battery-6s-5200mah/OldVersions/S6 22.2v - 5200 60C maH.0006.iam
Mechanical/CAD/vendor-parts/battery-6s-5200mah/OldVersions/Shrink Wrap.0003.ipt
Mechanical/CAD/vendor-parts/battery-6s-5200mah/OldVersions/Wrapper.0005.ipt
Mechanical/CAD/vendor-parts/battery-6s-5200mah/OldVersions/XT60H - Female.0001.ipt
Mechanical/CAD/vendor-parts/battery-6s-5200mah/Power Cable Assembly.iam
Mechanical/CAD/vendor-parts/battery-6s-5200mah/Power Cable.ipt
Mechanical/CAD/vendor-parts/battery-6s-5200mah/Shrink Wrap.ipt
Mechanical/CAD/vendor-parts/battery-6s-5200mah/Wrapper.ipt
Mechanical/CAD/vendor-parts/battery-6s-5200mah/XT60H - Female.ipt
Mechanical/CAD/vendor-parts/l298n-stepper-driver/L298N Driver.IGS
Mechanical/CAD/vendor-parts/l298n-stepper-driver/L298N Driver.SLDASM
Mechanical/CAD/vendor-parts/l298n-stepper-driver/Set Screw.SLDPRT
Mechanical/CAD/vendor-parts/nema17-stepper/Nema17.f3d
