CaptainBertie/D-Sentry/Hardware/Wiring Diagram/turret-wiring.png

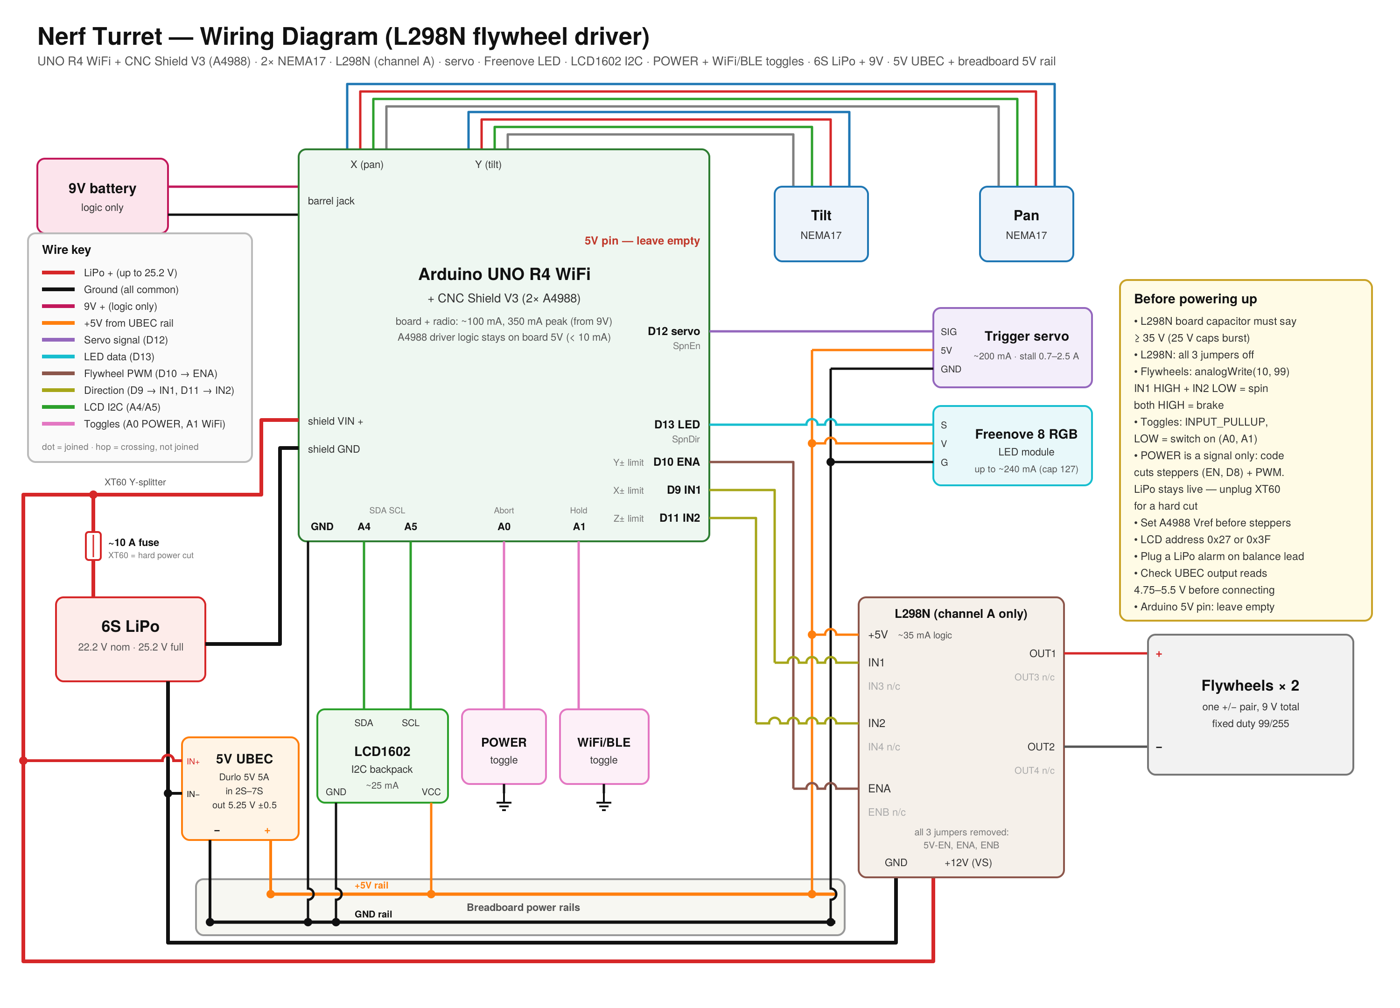
Hardware/Wiring Diagram/turret-wiring.png
