CaptainBertie/D-Sentry/Hardware/Wiring Diagram/versions/v00_mosfet-flywheel-driver.png

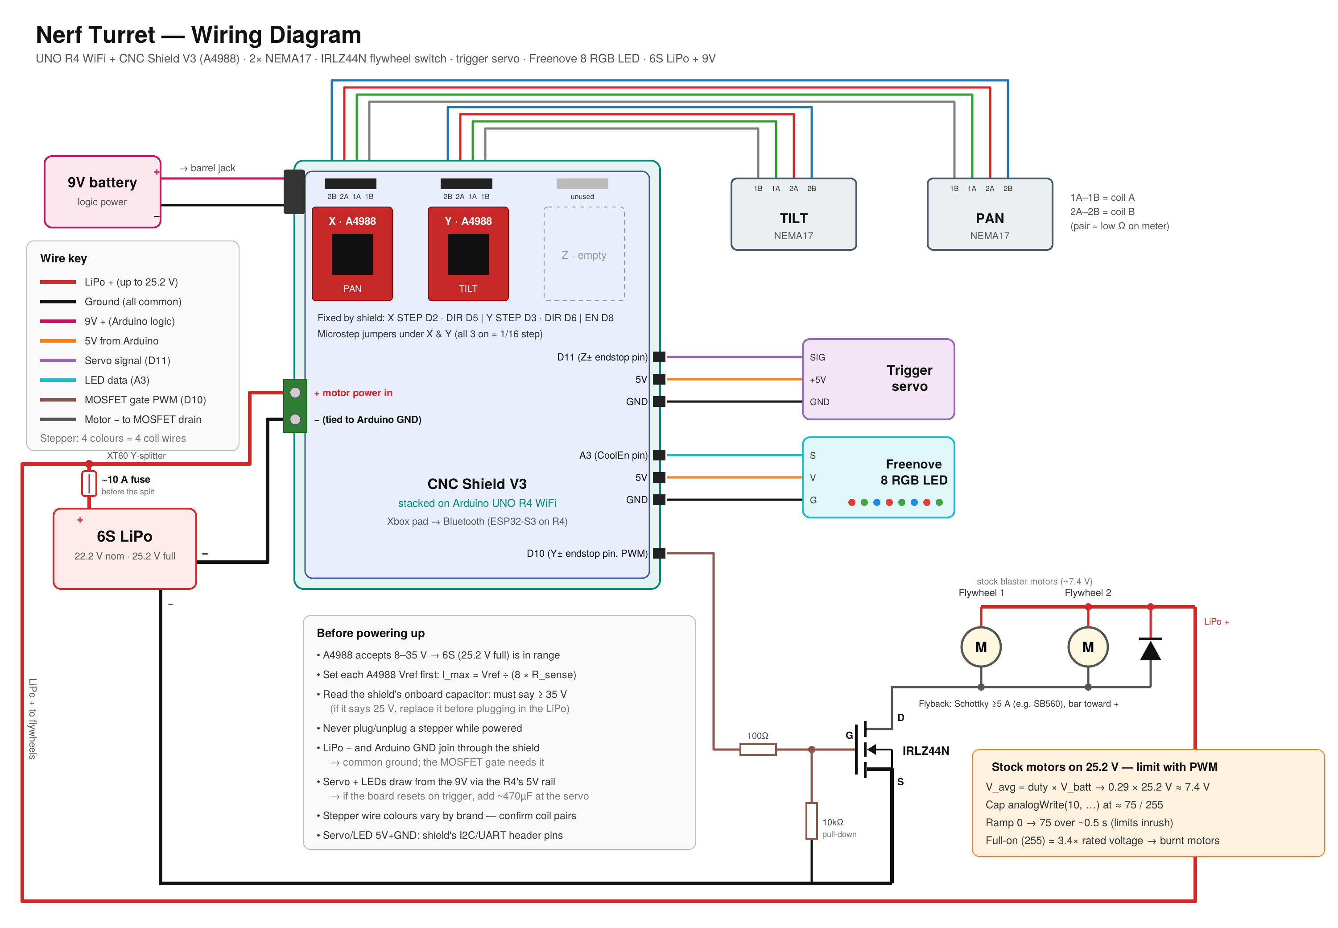
Hardware/Wiring Diagram/versions/v00_mosfet-flywheel-driver.png
