CaptainBertie/D-Sentry/Hardware/Wiring Diagram/versions/v01_bridged-channels_battery-sense.png

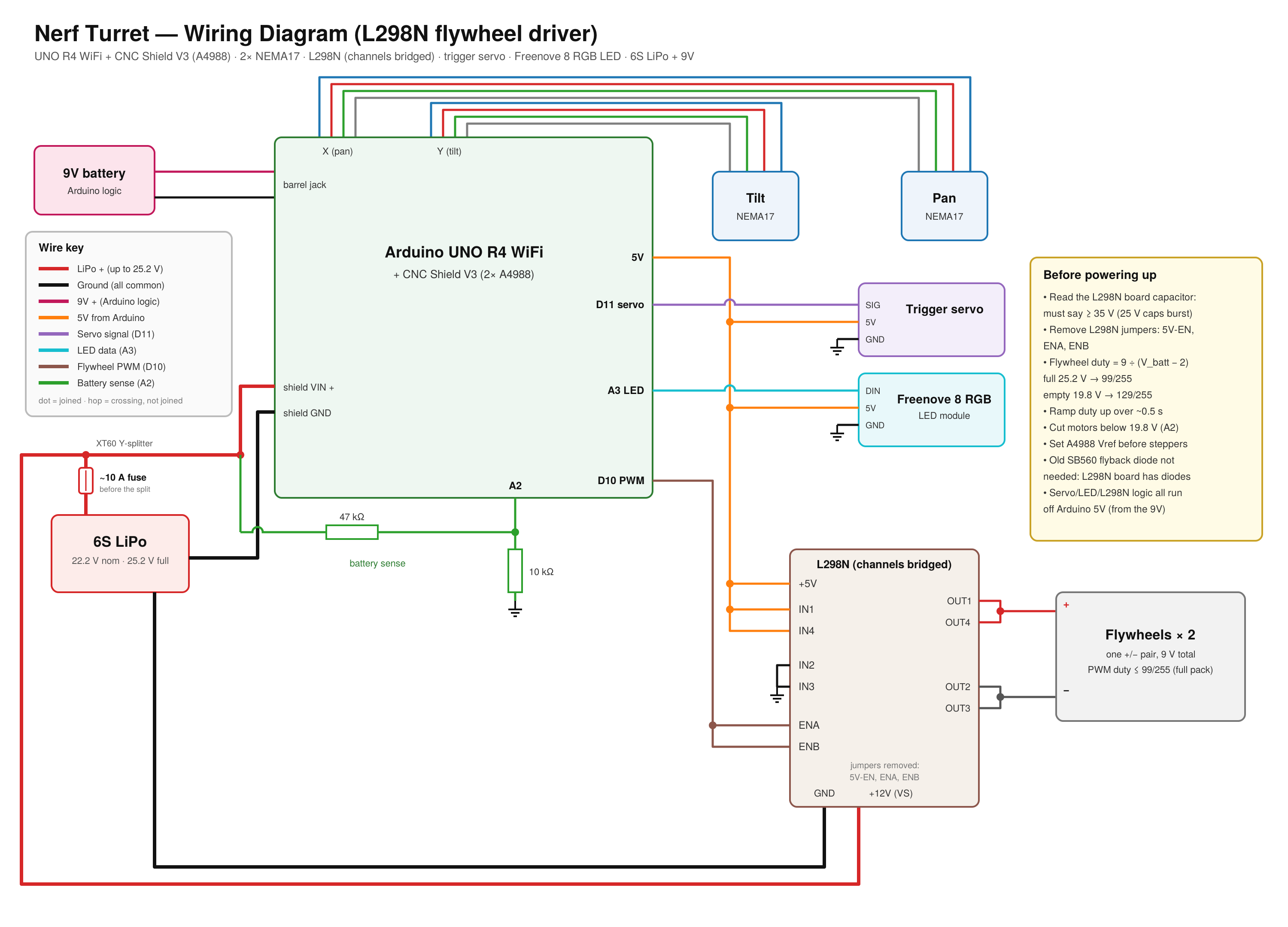
Hardware/Wiring Diagram/versions/v01_bridged-channels_battery-sense.png
