CaptainBertie/D-Sentry/Hardware/Wiring Diagram/versions/v02_lcd-hall-toggles_channel-A.png

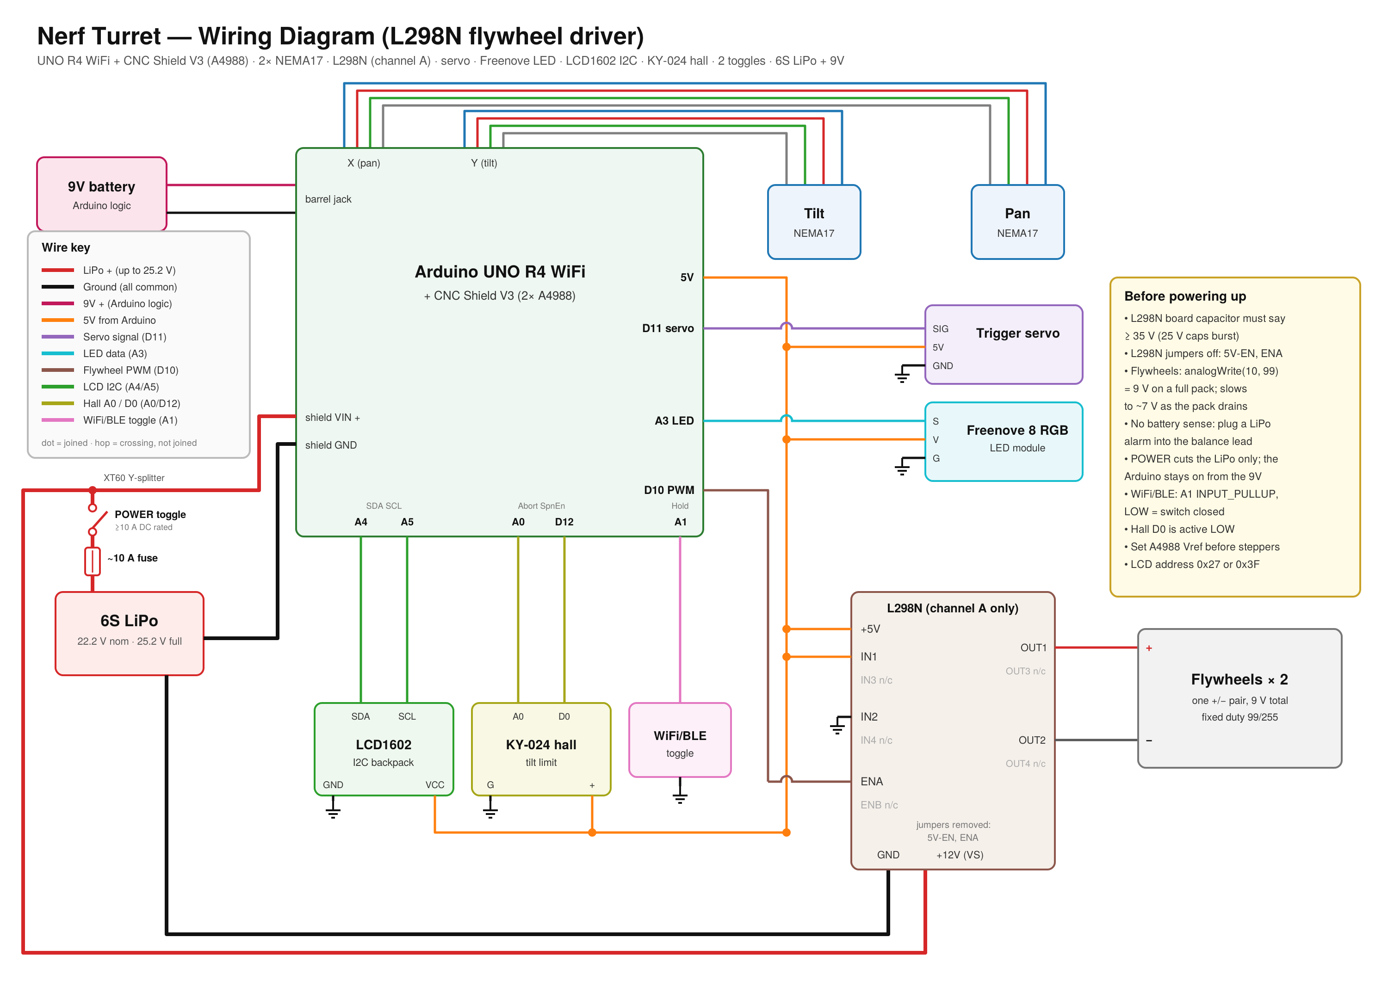
Hardware/Wiring Diagram/versions/v02_lcd-hall-toggles_channel-A.png
