CaptainBertie/D-Sentry/Hardware/Wiring Diagram/versions/v05_hall-removed_power-signal-toggle_IN3-IN4-pins.png

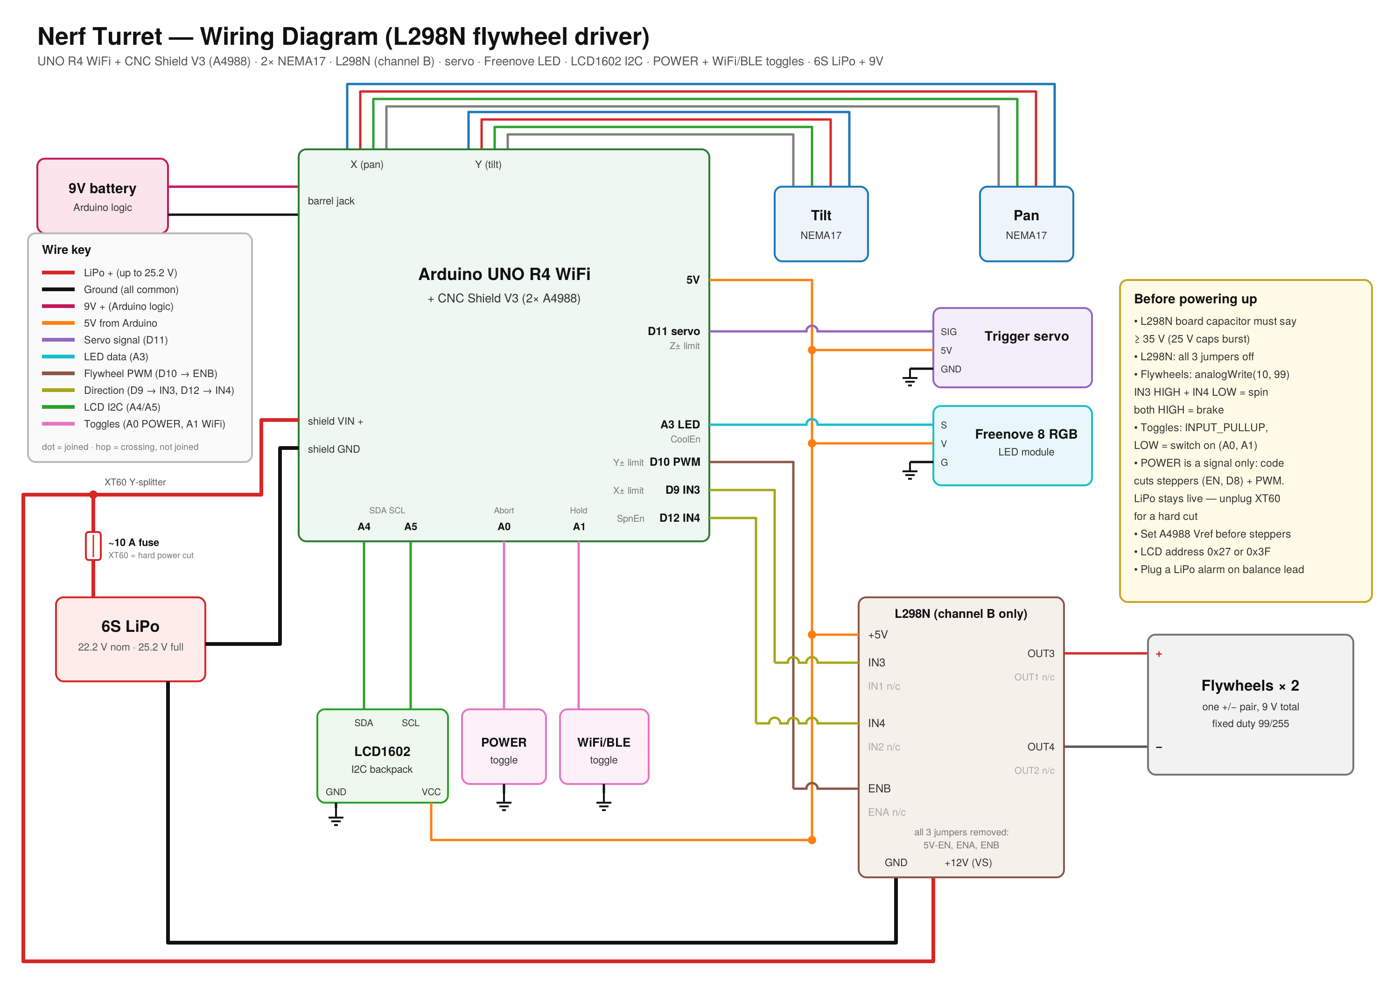
Hardware/Wiring Diagram/versions/v05_hall-removed_power-signal-toggle_IN3-IN4-pins.png
