CaptainBertie/D-Sentry/Software/Local Web Server for WiFi Connect Mode/dsentry/hub.py

# SPDX-License-Identifier: MIT
"""The dashboard's shared state (the pattern of tools/dashboard.py: a Condition plus a version
counter that rises on every change a page should see, and a per-boot token so a page notices a
relay restart). Transports feed it frames and text from their reader threads; HTTP threads read
JSON frames out of it.

The PC never re-computes turret logic: every turret value shown is the RA4M1's TelemetryPacket.
A packet is shown when its version byte matches the layout that arrived: DS_TELEMETRY_VERSION, or
version 1 from an older RA4M1 build (no controller block: the dashboard says "not reported by
this firmware"). Anything else is counted and never shown. With no packet for
DASHBOARD_STALE_MS the frame says "stale" and the page greys every turret value; before the
first packet it says "none".

The controller view (frame["controller"], the page's CONTROLLER panel) describes one source:
while the relay itself drives with its own pad, the keyboard or the demo script, that input's
full state as the relay holds it (the pad's left stick, left trigger and battery level included,
though only the right stick, right trigger and buttons are sent); otherwise (--monitor, or the
relay has no input) the controller block of the turret's TelemetryPacket, which in BT mode is
the pad paired with the turret.

The event log is derived here from consecutive TelemetryPackets (state changes, shots, magazine,
flywheel, home, toggles, ESP32 radio, reboots), plus relay notes (ports, keyboard, input source).
"""

import collections
import queue
import secrets
import threading
import time
from typing import Callable, List, Optional, Tuple

from . import protocol as P
from .relay import RumbleDedupe

_TF = P.TelemetryFlags

CONTROLLER_SINCE_VERSION = 2     # the TelemetryPacket version that appended padState..padButtons
PAD_FIELDS = ("padState", "padBattery", "padLx", "padLy", "padRx", "padRy", "padLt", "padRt", "padButtons")
BATTERY_MAX_PERCENT = 100

# What the dashboard says for each DS_PAD_STATE_* (protocol_spec.py PadState). SCANNING means
# "scanning" only for the BLE pad; for the relay's WiFi or USB packets it means "not connected".
PAD_STATE_TEXT = {
    P.DS_PAD_STATE_CONNECTED: "connected",
    P.DS_PAD_STATE_WAITING_FIRST_REPORT: "linked, waiting for the first report",
    P.DS_PAD_STATE_FOUND: "found, connecting",
    P.DS_PAD_STATE_SCANNING: "scanning, no pad connected",
    P.DS_PAD_STATE_OFF: "Xbox BLE client off",
    P.DS_PAD_STATE_BLOCKED_BY_HCI: "blocked: the HCI bridge owns the radio",
    P.DS_PAD_STATE_NONE: "no control source",
}
NOT_CONNECTED_TEXT = "not connected"

# Which source a controller view describes, as the page labels it.
SOURCE_LABELS = {
    "pad": "relay pad",
    "keyboard": "keyboard",
    "demo": "demo script (scripted pad)",
    P.DS_LINK_SRC_BLE: "pad on the turret (BLE)",
    P.DS_LINK_SRC_WIFI: "relay over WiFi (as the turret sees it)",
    P.DS_LINK_SRC_USB: "USB ControlPackets (as the turret sees it)",
    P.DS_LINK_SRC_NONE: "no control source",
}

# SDL's battery levels (SDL_joystick.h SDL_JoystickPowerLevel) as the page shows them.
SDL_POWER_TEXT = {
    "empty": "empty (<= 5 %)", "low": "low (<= 20 %)", "medium": "medium (<= 70 %)",
    "full": "full (<= 100 %)", "wired": "wired", "max": "max",
}


def enum_name(enum_cls, value: int) -> str:
    try:
        return enum_cls(value).name
    except ValueError:
        return "UNKNOWN(%d)" % value


def deg(cdeg: int) -> float:
    return cdeg / P.DS_ANGLE_SCALE


def lcd_rows(text: str) -> List[str]:
    cols = P.DS_TELEMETRY_LCD_COLS
    return [text[i * cols:(i + 1) * cols] for i in range(P.DS_TELEMETRY_LCD_ROWS)]


def telemetry_layout_ok(pkt: P.TelemetryPacket, payload_len: Optional[int] = None) -> bool:
    """The version byte names the layout that arrived (payload_len None = the current one):
    DS_TELEMETRY_VERSION, or an older version at its own exact length."""
    layout = P.DS_TELEMETRY_VERSION if payload_len is None else P.TelemetryPacket.layout_version(payload_len)
    return layout is not None and pkt.version == layout


def controller_reported(pkt: P.TelemetryPacket) -> bool:
    return pkt.version >= CONTROLLER_SINCE_VERSION


def telemetry_view(pkt: P.TelemetryPacket) -> dict:
    d = pkt.to_dict()
    reported = controller_reported(pkt)
    d.update({
        "stateName": enum_name(P.TurretState, pkt.state),
        "faultName": enum_name(P.Fault, pkt.fault),
        "fireModeName": enum_name(P.FireMode, pkt.fireMode),
        "linkSourceName": enum_name(P.LinkSource, pkt.linkSource),
        "espModeName": enum_name(P.EspMode, pkt.espMode),
        "flagBits": P.bits_to_dict("TelemetryFlags", pkt.flags),
        "panDeg": deg(pkt.panCdeg), "tiltDeg": deg(pkt.tiltCdeg),
        "panVelDegS": deg(pkt.panVelCdegS), "tiltVelDegS": deg(pkt.tiltVelCdegS),
        "homePanDeg": deg(pkt.homePanCdeg), "homeTiltDeg": deg(pkt.homeTiltCdeg),
        "lcdRows": lcd_rows(pkt.lcd),
        "controllerReported": reported,
        "padStateName": enum_name(P.PadState, pkt.padState) if reported else None,
        "padButtonBits": P.bits_to_dict("Buttons", pkt.padButtons) if reported else None,
    })
    if not reported:                 # an older build: the decoder's defaults are not facts
        for name in PAD_FIELDS:
            d[name] = None
    return d


def battery_text_percent(value: Optional[int]) -> str:
    if value is None or value == P.DS_PAD_BATTERY_UNKNOWN:
        return "unknown"
    if value > BATTERY_MAX_PERCENT:
        return "invalid (%d)" % value
    return "%d %%" % value


def pad_state_text(state: int, link_source: int) -> str:
    if state == P.DS_PAD_STATE_SCANNING and link_source != P.DS_LINK_SRC_BLE:
        return NOT_CONNECTED_TEXT
    return PAD_STATE_TEXT.get(state, "unknown state %d" % state)


def _sticks(lx=0, ly=0, rx=0, ry=0, lt=0, rt=0, buttons=0) -> dict:
    return {"lx": lx, "ly": ly, "rx": rx, "ry": ry, "lt": lt, "rt": rt, "buttons": buttons,
            "buttonBits": P.bits_to_dict("Buttons", buttons)}


def turret_controller_view(pkt: Optional[P.TelemetryPacket], telemetry_state: str) -> dict:
    """The controller block of the latest TelemetryPacket, for the page."""
    view = {"origin": "turret", "source": None, "label": "the turret's report", "name": "",
            "reported": False, "live": telemetry_state == "live", "connected": False,
            "state": None, "stateName": None, "stateText": "", "level": "bad", "battery": None,
            "batteryText": "unknown", "note": "", "sent": None}
    view.update(_sticks())
    if pkt is None or telemetry_state in ("none", "badVersion"):
        view["note"] = ("telemetry version mismatch" if telemetry_state == "badVersion"
                        else "no telemetry yet")
        return view
    view["source"] = pkt.linkSource
    view["label"] = SOURCE_LABELS.get(pkt.linkSource, "link source %d" % pkt.linkSource)
    if not controller_reported(pkt):
        view["note"] = "not reported by this firmware (TelemetryPacket v%d)" % pkt.version
        return view
    view.update(_sticks(pkt.padLx, pkt.padLy, pkt.padRx, pkt.padRy, pkt.padLt, pkt.padRt, pkt.padButtons))
    view.update({
        "reported": True,
        "connected": pkt.padState == P.DS_PAD_STATE_CONNECTED,
        "state": pkt.padState, "stateName": enum_name(P.PadState, pkt.padState),
        "stateText": pad_state_text(pkt.padState, pkt.linkSource),
        "level": ("ok" if pkt.padState == P.DS_PAD_STATE_CONNECTED else
                  "bad" if pkt.padState == P.DS_PAD_STATE_NONE else "warn"),
        "battery": None if pkt.padBattery == P.DS_PAD_BATTERY_UNKNOWN else pkt.padBattery,
        "batteryText": battery_text_percent(pkt.padBattery),
    })
    if pkt.linkSource != P.DS_LINK_SRC_BLE and pkt.padState != P.DS_PAD_STATE_NONE:
        view["note"] = "a ControlPacket has no left stick, left trigger or battery level"
    return view


def relay_controller_view(source: str, values, hold_ms: int = 0, deadman: bool = False) -> dict:
    """The relay's own input (pad, keyboard or demo script) with everything it knows."""
    if source == "keyboard":
        battery_text = "n/a (keyboard)"
    elif values.battery is not None:
        battery_text = battery_text_percent(values.battery)
    else:
        battery_text = SDL_POWER_TEXT.get(values.power, "unknown")
    if deadman:
        state_text = "enabled, but deadman: neutral (no key state from the page)"
    elif hold_ms:
        state_text = "connected; source change: sending connected=0 for %d ms" % hold_ms
    else:
        state_text = "connected, driving the turret" if source != "keyboard" else "driving the turret"
    view = {"origin": "relay", "source": source, "label": SOURCE_LABELS.get(source, source),
            "name": values.name, "reported": True, "live": True, "connected": True,
            "state": None, "stateName": None, "stateText": state_text,
            "level": "warn" if (deadman or hold_ms) else "ok",
            "battery": values.battery, "batteryText": battery_text,
            "note": "the turret receives the right stick, right trigger and buttons only",
            "sent": ["rx", "ry", "rt", "buttons"]}
    view.update(_sticks(values.lx, values.ly, values.rx, values.ry, values.lt, values.rt, values.buttons))
    return view


def status_view(pkt: P.StatusPacket) -> dict:
    d = pkt.to_dict()
    d["stateName"] = enum_name(P.TurretState, pkt.state)
    d["wantModeName"] = enum_name(P.RadioMode, pkt.wantMode)
    return d


def _flag(pkt, bit) -> bool:
    return bool(pkt.flags & bit)


def _onoff(value: bool, on: str, off: str) -> str:
    return on if value else off
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
