CaptainBertie/D-Sentry/Software/Local Web Server for WiFi Connect Mode/dsentry/web.py

# SPDX-License-Identifier: MIT
"""The dashboard's HTTP server (architecture.md 7): stdlib ThreadingHTTPServer, HTTP/1.1.

Routes
  GET  /                 relay-pc/web/index.html (read per request, so edits show on reload)
  GET  /config           config.h values the page needs, enum names, the key map, and the per-boot
                         keyboard token -- the token only for a loopback client whose Host header
                         names this server (DNS-rebinding guard)
  GET  /state            one JSON frame (hub.frame)
  GET  /events           server-sent events: a frame per change, coalesced to DASHBOARD_MAX_FPS,
                         "event: ping" after DASHBOARD_KEEPALIVE_MS of quiet
  POST /keyboard/enable  -> {"session": id}
  POST /keyboard/state   {"session", "seq", "levels": {...}, "presses": {...}}
  POST /keyboard/disable {"session"}
Every POST needs: a loopback client, an allowed Host header, the X-DSentry-Token header equal to
the boot token, and Content-Type application/json. OPTIONS is answered 405 with no CORS headers,
so a cross-origin page can never pass the preflight that the custom header forces.
"""

import json
import threading
import time
from http.server import BaseHTTPRequestHandler, ThreadingHTTPServer
from pathlib import Path

from . import keyboard as K
from . import protocol as P

PAGE_PATH = Path(__file__).resolve().parents[1] / "web" / "index.html"
MAX_POST_BYTES = 4096            # a key-state body is ~300 bytes
HANDLER_SOCKET_TIMEOUT_S = 30    # an idle keep-alive or stalled client frees its thread after this
SSE_WAIT_SLICE_S = 0.5           # how often an idle SSE loop re-checks stop and the keepalive

# config.h names the page reads from /config (presentation and display ranges only).
PAGE_CONFIG_NAMES = (
    "CONTROL_PACKET_HZ", "LINK_TIMEOUT_MS", "TELEMETRY_USB_HZ", "TELEMETRY_WIFI_HZ",
    "KEYBOARD_POST_HZ", "KEYBOARD_DEFLECTION", "KEYBOARD_PRESS_MS", "KEYBOARD_REVOKE_MS",
    "DASHBOARD_MAX_FPS", "DASHBOARD_KEEPALIVE_MS", "DASHBOARD_EVENT_LOG_KEEP", "DASHBOARD_STALE_MS",
    "TILT_RANGE_DEG", "PAN_LIMITS_ENABLED", "PAN_MIN_DEG", "PAN_MAX_DEG", "SOFT_LIMIT_SLOWDOWN_DEG",
    "PAN_MAX_DEG_PER_S", "TILT_MAX_DEG_PER_S", "MAG_CAPACITY", "LED_COUNT", "LED_MAX_BRIGHTNESS",
    "LED_CHANNEL_MAX", "LCD_COLS", "LCD_ROWS", "FLYWHEEL_DUTY_255", "FLYWHEEL_SPINUP_MS",
    "PWM_MAX", "STALL_DELTA_COUNTS", "ADC_MAX_COUNTS", "STEP_JITTER_LIMIT_PERMILLE", "PERMILLE",
    "JOY_AXIS_RANGE", "TRIGGER_AXIS_RANGE", "JOY_DEADZONE", "TRIGGER_PRESS_THRESHOLD",
    "TRIGGER_RELEASE_THRESHOLD", "TRIGGER_REST_ANGLE", "TRIGGER_FIRE_ANGLE", "TRIGGER_PREFIRE_ANGLE", "TRIGGER_CLEAR_ANGLE",
    "SERVO_SPAN_DEG",
    # the CONTROLLER MAP panel's labels and which actions the turret's state refuses
    "FLYWHEEL_HOLD_MODE", "FLYWHEEL_REQUIRES_ARMED", "FIRE_REQUIRES_FLYWHEEL", "FIRE_LOCKOUT_WHEN_EMPTY",
    "ARM_REQUIRES_TRIGGER_RELEASED", "LCD_TXT_SERVO_TEACH", "SERVO_TEACH_STEP_SMALL_DEG",
    "SERVO_TEACH_STEP_LARGE_DEG",
)


def page_config(settings, hub, kb, local: bool) -> dict:
    cfg = {}
    for name in PAGE_CONFIG_NAMES:
        value = settings.value(name)
        cfg[name] = value if isinstance(value, (bool, int, float)) or value is None else str(value)
    enums = {e.__name__: {m.value: m.name for m in e} for e in
             (P.TurretState, P.Fault, P.FireMode, P.LinkSource, P.EspMode, P.RadioMode, P.PadState)}
    return {
        "boot": hub.boot,
        "demo": hub.demo,
        "mode": hub.mode,
        "token": kb.token if (local and kb is not None) else None,
        "tokenHeader": K.TOKEN_HEADER,
        "keyboardAllowed": bool(local and kb is not None),
        "config": cfg,
        "enums": enums,
        "bits": {name: list(bits) for name, bits in P.BIT_KEYS.items()},
        "keys": [{"codes": list(codes), "action": action, "key": key} for codes, action, key in K.KEY_MAP],
        "angleScale": P.DS_ANGLE_SCALE,
    }
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
