CaptainBertie/D-Sentry/(commit log)

2026-11-13 D-Sentry: curated public repo
    Organized out of the private development workspace into Mechanical/Hardware/
    Software, with a new top-level README, LICENSE (MIT) and NOTICE.md explaining
    the AGPL-3.0 status of the ESP32-S3 firmware image. The ESP32 firmware fork's
    vendored dependencies are re-declared as git submodules pinned to the exact
    vendored commits, pointing at their real upstream URLs.
    DECISIONS.md, THIRD_PARTY.md and D-SENTRY_SPEC.md carried over from the
    original project for history. Left as open TODOs: native Fusion 360 CAD
    source for the turret's own parts, measured fitment values, and BOM purchase
    links.
    Claude-Session: htt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
    [1602 LCD.stp, 3.7v Cell.0005.ipt, 3.7v Cell.ipt, 6S 22.2v 5200maH 60C .iam, 6S 22.2v 5200maH 60C .stp, Arduino_CNC_Assembly.STEP, BLS-3 by Dmitry Levin.step, BLS-3 by Dmitry Levin.step.SLDPRT]
2026-11-13 BOM: drop the Link column; credit GearForge for the gear models
    The purchase-link column in BOM.md was empty TODOs with no real links, so
    it's gone — notes already say what to fill in. Added a mention of
    GearForge (the Fusion 360 ISO-gear add-in built alongside this project)
    to Mechanical/CAD/README.md and the top-level README, since it's what
    generated this turret's gear profiles.
    Claude-Session: https://claude.ai/code/session_01GUwMLDxycH1BgAtzAvC9EW
2026-11-13 Add a handoff inbox and start a wiring-diagram changelog
    Set up handoff-inbox/README.md as the process doc for pulling context out
    of a separate Claude.ai Project via Claude Artifacts (listable/readable
    across sessions on the same account), rather than losing it to copy-paste.
    Hardware/Wiring Diagram/ gets a README and CHANGELOG.md. There's no prior
    version history to recover for these diagrams -- they were never
    committed anywhere before this repo -- so this starts revision 1 and
    documents the convention (own commit + changelog entry per revision) going
    forward.
    Claude-Session: https://claude.ai/code/session_01GUwMLDxycH1BgAtzAvC9EW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
2026-11-13 Mechanical/CAD: add native Fusion 360 source
    Turret.f3z (main assembly), Shooter.f3z, Flywheel cage.f3d and Fit Panel.f3d
    in CAD/source/ -- the editable design that was previously missing, only
    available before as sliced/exported meshes. Nema17.f3d split out to
    vendor-parts/ alongside the other purchased-part reference models, since
    it's a stepper reference model rather than part of the turret's own
    design.
    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
    [Fit Panel.f3d, Flywheel cage.f3d, Nema17.f3d, Shooter.f3z, Turret.f3z]
2026-11-13 Fold in the 2026-11-13 Claude Project handoff
    Pulled in three handoff artifacts (BOM/sources, mechanical findings,
    hardware decisions) plus one pre-existing artifact surfaced while
    searching (a firmware architecture/flowchart page). Logged in
    handoff-inbox/README.md.
    - Hardware/BOM/BOM.md: real part numbers and sources where chats had them
    (A4988 confirmed via Amazon order history, flywheel motors salvaged from
    a Zuru blaster, the UBEC, etc.), conflicts flagged rather than resolved
    (stepper source, servo model), gaps stated plainly (LiPo charger,
    magnets, fastener list).
    - DECISIONS.md D20-D25: the 5V UBEC added after the spec was written (and
    the spec question that was never answ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
2026-11-13 Re-sync from turret-live, fix an exposed credential, pull in Notion fitment/BOM data
    This repo was built from the d-sentry branch. The owner's own recap made clear
    that's wrong: d-sentry was rolled back before an LED scheme and a servo
    flash-save feature were ever flashed, and a separate branch, turret-live, took
    over from there with 13 more commits of real bench tuning. That's what's
    actually on the turret.
    - Software/Turret Code for the Arduino/, Software/System Block Diagram/
    architecture.md, Software/Custom Firmware/protocol/, and the PC relay are
    re-synced from turret-live. ServoStore.cpp/.h (the rolled-back flash-save
    feature) is removed, not just stale.
    - Security fix: turret-l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
    [App.h, Debug.cpp, Debug.h, Lcd.cpp, Lcd.h, Leds.cpp, Leds.h, Telemetry.cpp]
2026-11-13 Polish for presentation: real wiring history, closed open items
    Added the real wiring-diagram version history (v00-v09, from an archive
    of the actual revisions) to Hardware/Wiring Diagram/versions/, with v09
    promoted to the current top-level turret-wiring.png and the original
    MOSFET-era v00 moved into history. Restored the real WiFi AP password in
    config.h -- it's just the turret's own local access point, not a secret
    worth redacting.
    Resolved the rack/frame gcode question using the build's own order-of-
    operations records: Rack (31m) and Frame (18h23m) are final; the rest are
    testing iterations.
    Cleaned up every doc that was carrying development-process narration
    (chat-history handoffs, N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
    [config.h]
2026-11-13 Docs: tighten and reorganise; point submodules at public URLs
    - .gitmodules: submodules pointed at absolute paths on the dev machine, so
    every clone got empty folders. They now use the upstream GitHub repos at
    the same pinned commits.
    - Software/System Block Diagram/ folded into Software/; its README is now
    the Software index.
    - NOTICE.md merged into THIRD_PARTY.md; the wiring CHANGELOG merged into
    its README; single-file folders flattened (Hardware/BOM.md,
    Mechanical/fitment.md).
    - README, BOM, Mechanical and wiring docs rewritten shorter and plainer.
    - DECISIONS.md and architecture.md: path notes for the repo layout and
    fixed links; no content cut.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
2026-11-13 Software: new control-flow block diagram
    Replaces architecture-diagram.png; drops the old .svg, which showed the
    previous diagram.
    Claude-Session: https://claude.ai/code/session_01GUwMLBEDZ8veD3VybtHppt
